Yowie-Tool/Scanner-Dev/Simulator/Pix/first-test.png

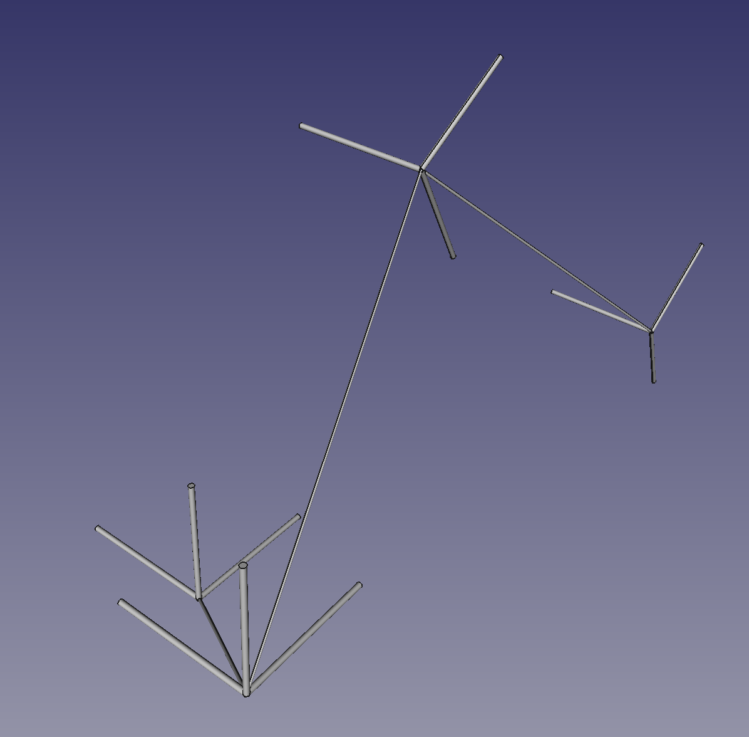
Simulator/Pix/first-test.png
