Yowie-Tool/Scanner-Dev/Simulator/Pix/calibration.png

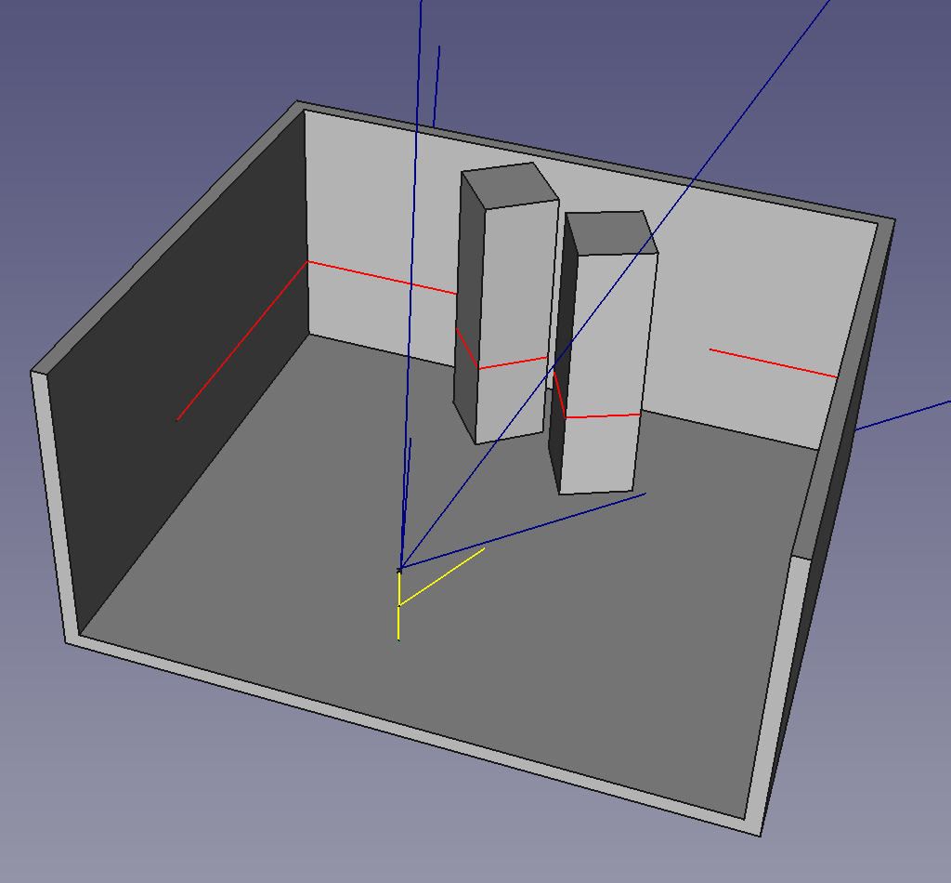
Simulator/Pix/calibration.png
