Yowie-Tool/Scanner-Dev/Simulator/net demand picture v0.2.pptx

+50GW
~50% peak

Interconnector imports

Demand Side Response reduction

Nuclear and Geothermal

Hydrogen

Gas/CCS

Variable renewables only

Batteries and electrically
connected storage use

Net Demand (GW)

CHP

Surplus
(~35% of demand)

Use electricity instead of gas in homes

4000

8640

Deficit

Electrolysis creation
of hydrogen

Hours in year

Store heat

Curtail

Batteries and electrically
connected storage store

Demand Side Response
increase

Interconnector exports

-75GW
