Yowie-Tool/Scanner-Dev/Line Generator/sch1.pdf

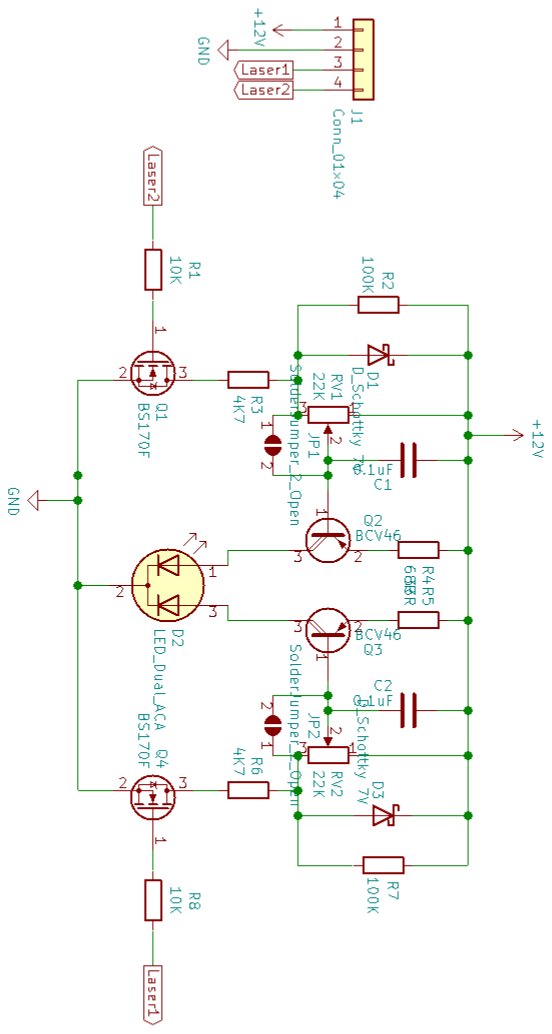
[picture p3: figure]
