Yowie-Tool/Scanner-Dev/Simulator/scanner-error-and-A4-paper-edge-error.ods

Sheet: Sheet1
A4 error | World error
2.96E-11 | 2.07E-11
0.356582834584444 | 0.332942094232495
1.72943543038597 | 1.504357195334
7.50455844831654 | 6.35880334547399
14.3673936406386 | 12.1409991132736
9.78756537702958 | 8.43348527156526
23.6512075498361 | 19.966038607182
46.2608296954759 | 39.261780496724
72.414954830534 | 60.9228884030703
7.04366456682111 | 6.64487412981304
15.2790453416857 | 12.7606081671749
28.3280096288787 | 23.4208571193749
8.31595921452953 | 6.75978969334771
6.75575197121302 | 5.62966116475005
108.781945717244 | 91.3980670708236
51.9931358986265 | 43.6328794534397
37.9781064290804 | 31.4948705997643
25.0638544390871 | 21.7473431589903
10.0748853756272 | 8.37942996782673
36.1126770885016 | 30.5700357944797
89.5823621274084 | 75.5083324300285
94.2375481575226 | 79.4631719529099
71.0746682839919 | 60.000725936289
36.0093804501391 | 29.7812720598132
134.895413170981 | 113.282342240537
57.2119686107465 | 48.8719196907314
99.3585794720821 | 84.4461999838592
142.955585669531 | 120.36169641654
184.773965671629 | 156.56932523244
42.9611357701024 | 36.1425294298019
60.8626346949404 | 52.6046704288228
28.4141960568925 | 24.3986715544768
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
