Yowie-Tool/Scanner-Dev/Line Generator/Line-generator-V2/prototype-stripboard.jpg

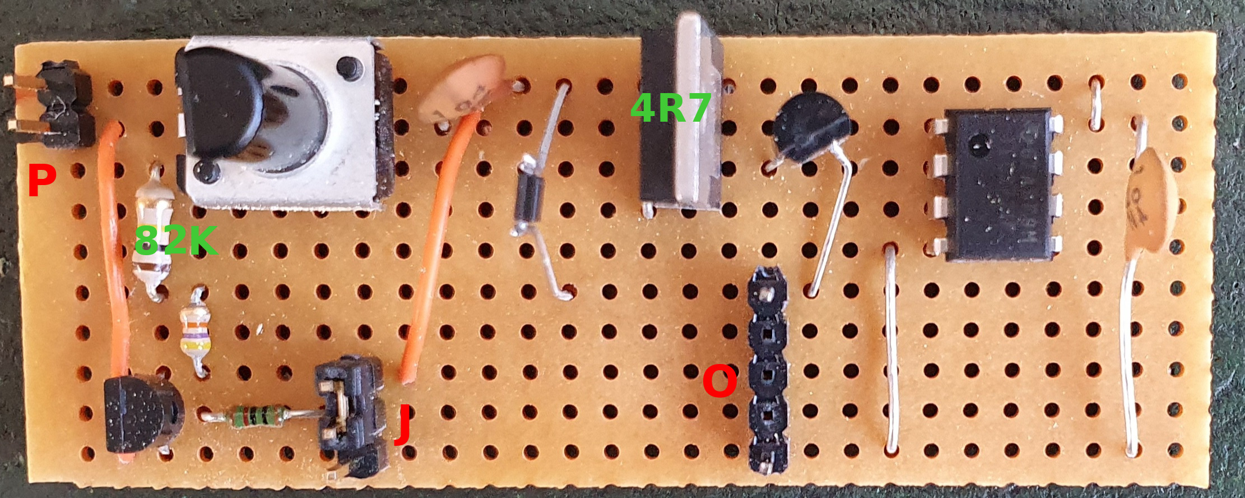
Line Generator/Line-generator-V2/prototype-stripboard.jpg
