Yowie-Tool/Scanner-Dev/Simulator/Pix/correct-output.png

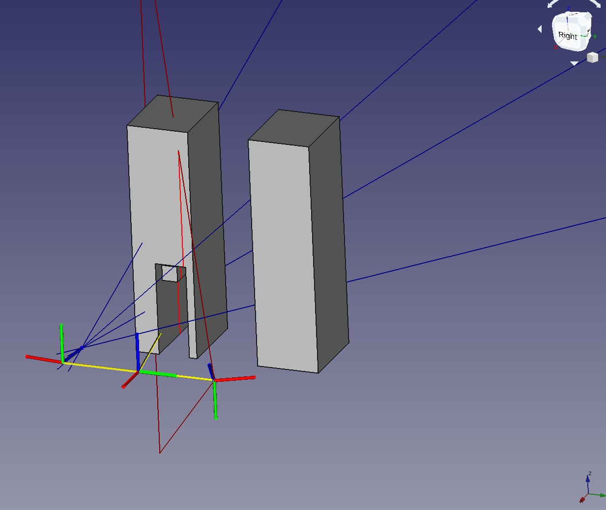
Simulator/Pix/correct-output.png
