Yowie-Tool/Scanner-Dev/Simulator/Pix/first-full-simulation.png

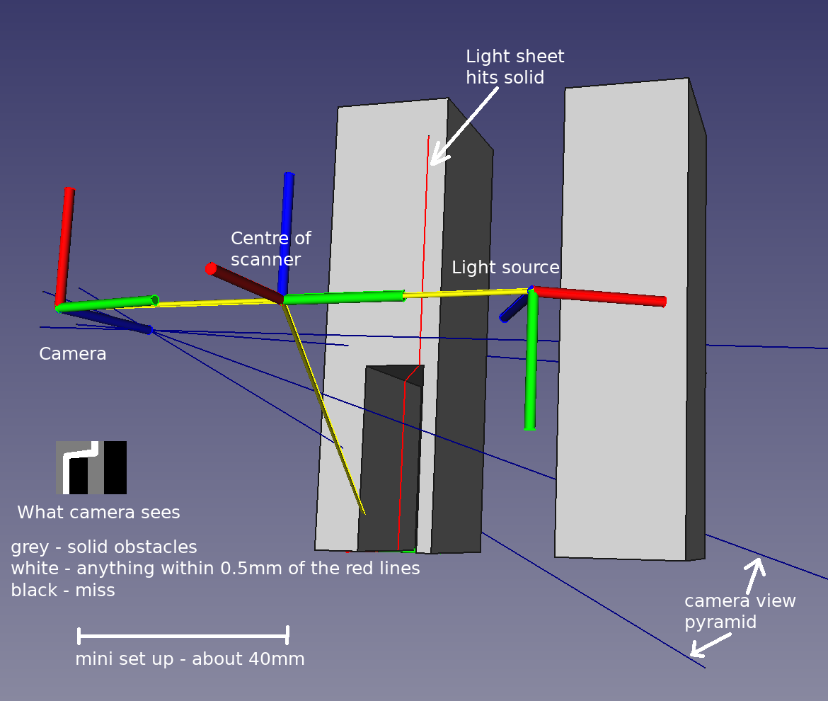
Simulator/Pix/first-full-simulation.png
