Yowie-Tool/Scanner-Dev/Simulator/Pix/light-sheet.png

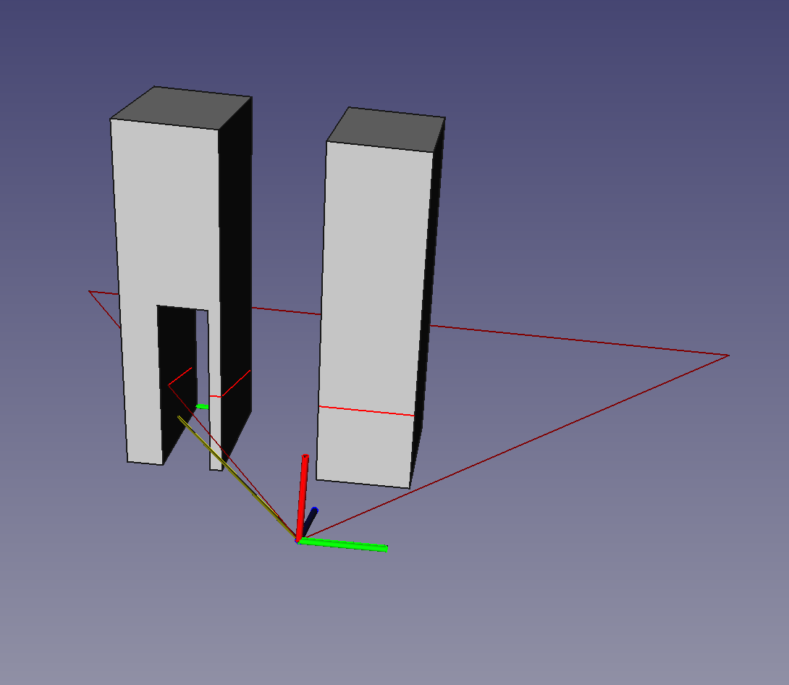
Simulator/Pix/light-sheet.png
