Yowie-Tool/Scanner-Dev/Simulator/Pix/light-slice.png

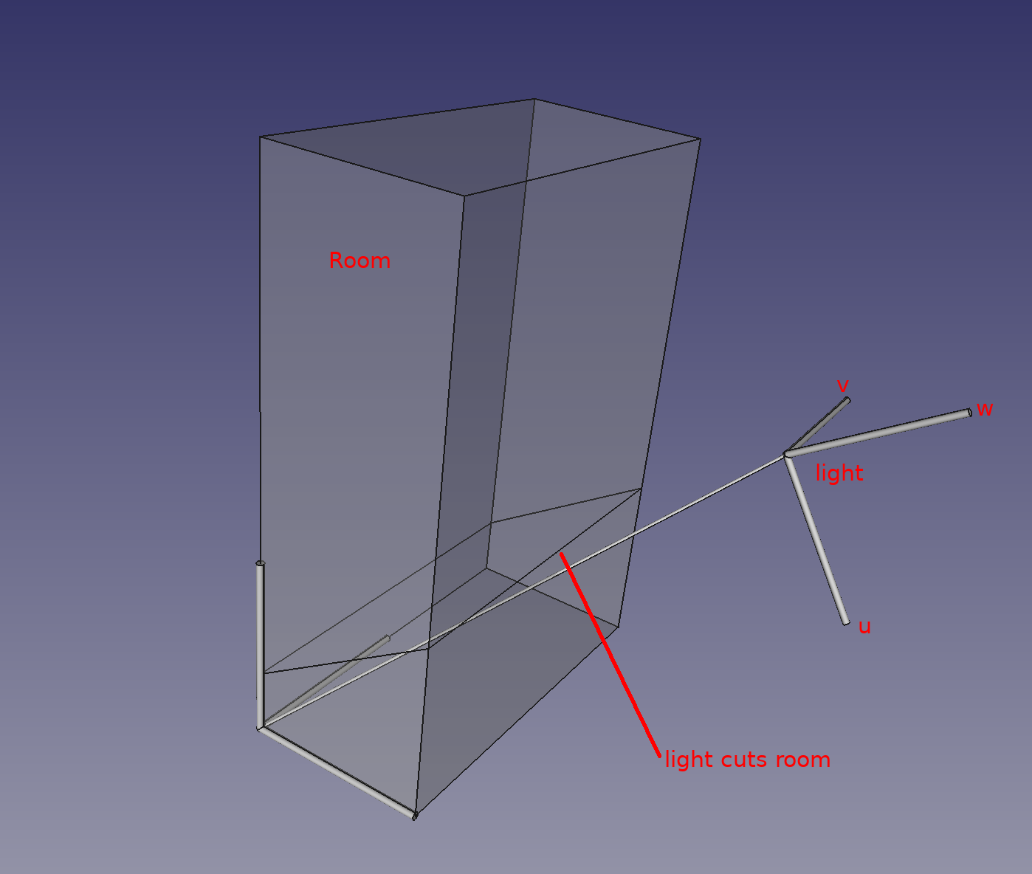
Simulator/Pix/light-slice.png
