Yowie-Tool/Scanner-Dev/Simulator/Pix/vispol.png

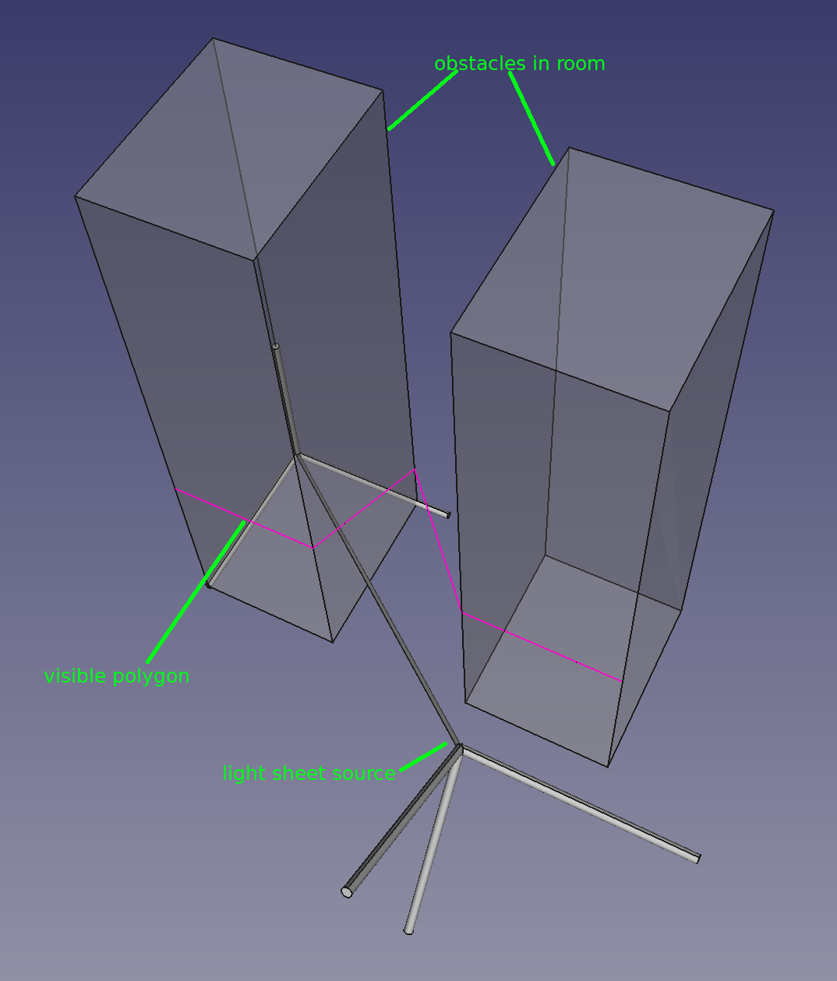
Simulator/Pix/vispol.png
