Yowie-Tool/Scanner-Dev/Simulator/scan.png

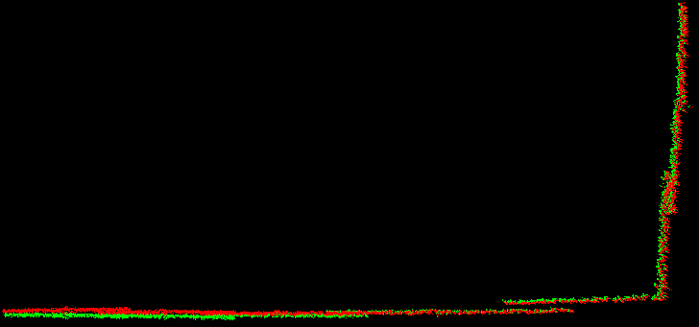
Simulator/scan.png
