Yowie-Tool/Scanner-Dev/Simulator/scanner-comparison1310.png

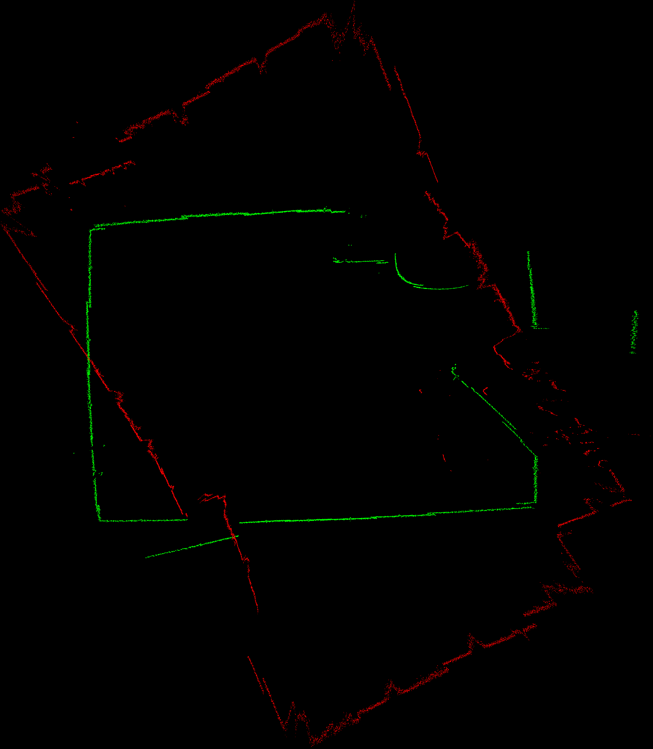
Simulator/scanner-comparison1310.png
