Yowie-Tool/Scanner-Dev/Simulator/scanner-comparison1310a.png

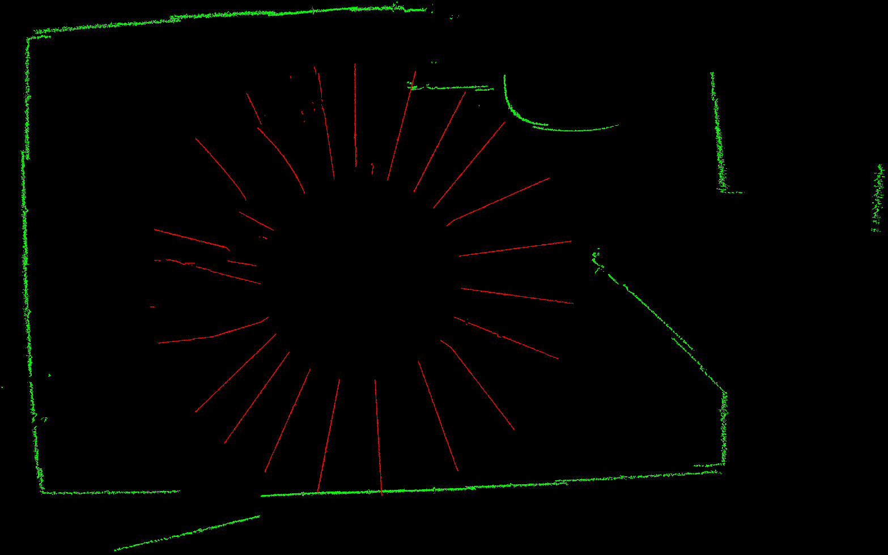
Simulator/scanner-comparison1310a.png
