Yowie-Tool/Scanner-Dev/Simulator/scanner-comparison.png

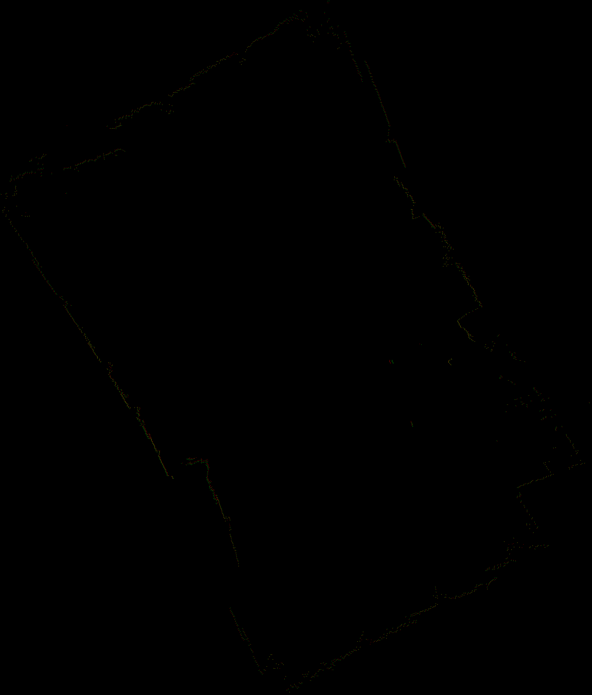
Simulator/scanner-comparison.png
