Yowie-Tool/Scanner-Dev/Simulator/triscan.png

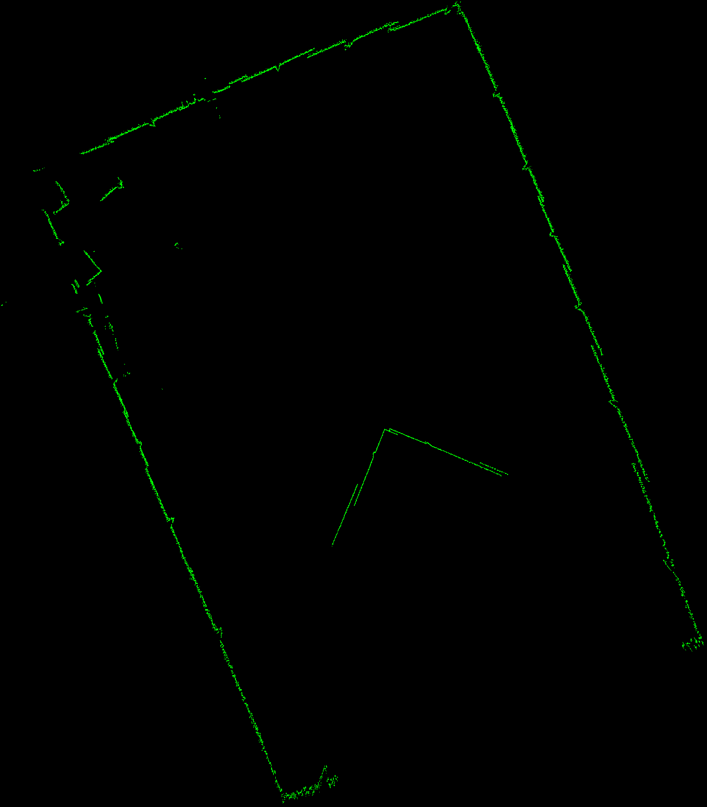
Simulator/triscan.png
