Yowie-Tool/Scanner-Dev/lens-holders.3mf

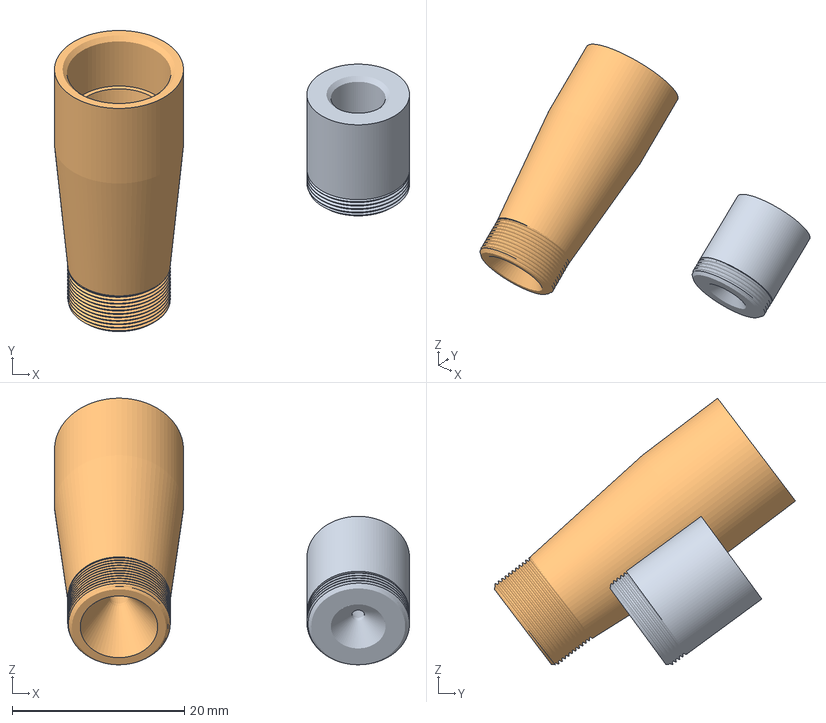
[picture p15: CAD file, 2020-10-10]
lens-holders.3mf
41.3 x 35.0 x 31.0 mm
SS2DP078 7.5mm Focal length lens holder - SLA .stl
SS2DP079 25mm Focal length lens holder - SLA v2.stl
