Yowie-Tool/Scanner-Dev/Line Generator/line-gen-mnt-no-disc.FCStd

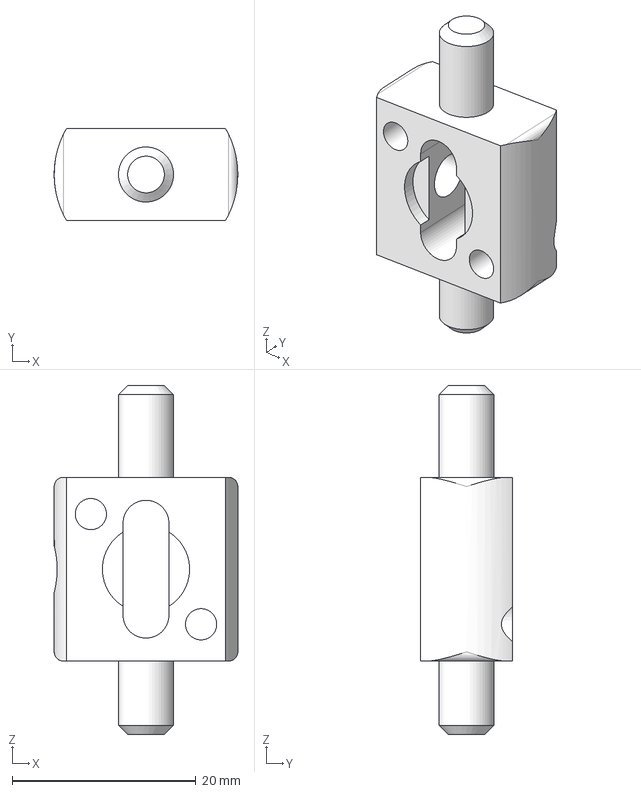
[picture p16: CAD file, 2020-10-10]
Line Generator/line-gen-mnt-no-disc.FCStd
20.0 x 10.0 x 38.0 mm
