Yowie-Tool/Scanner-Dev/Line Generator/Line-generator-V2/3386w-1-103lf.stp

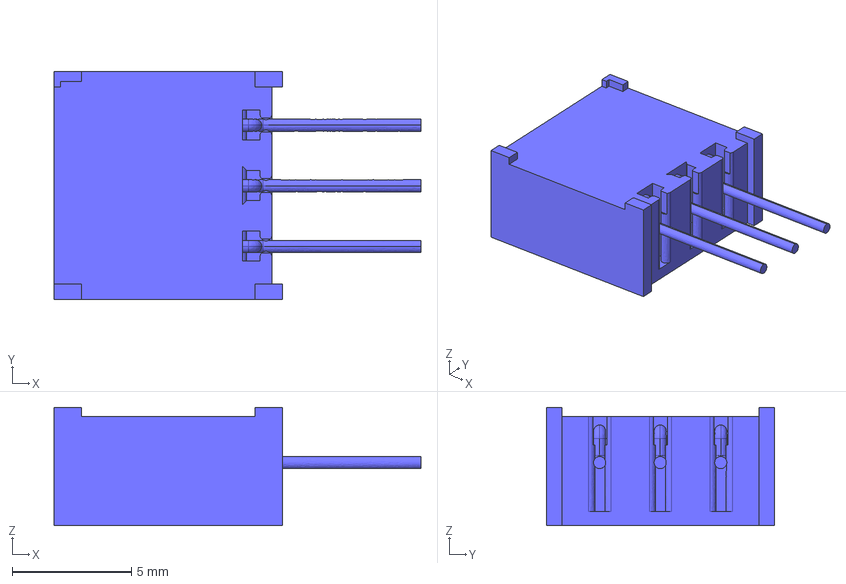
[picture p17: CAD file, 2021-01-26]
Line Generator/Line-generator-V2/3386w-1-103lf.stp
15.4 x 9.58 x 4.95 mm
