Yowie-Tool/Scanner-Dev/New Top Board/FSA642UMX-pcb-part-libraries/FSA642UMX.stp

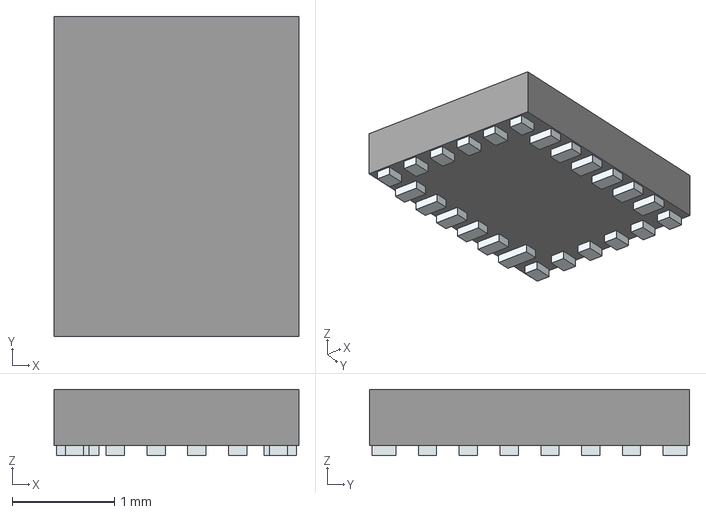
[picture p18: CAD file, 2020-06-26]
New Top Board/FSA642UMX-pcb-part-libraries/FSA642UMX.stp
2.40 x 3.14 x 0.65 mm
Pins
