Yowie-Tool/Scanner-Dev/STL/james-11-10-20.3mf

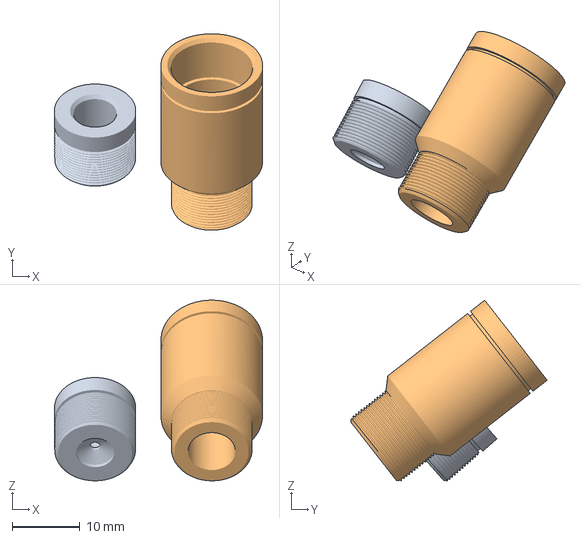
[picture p19: CAD file, 2020-11-02]
STL/james-11-10-20.3mf
30.7 x 29.0 x 26.7 mm
SS2DP076 7.5mm Focal length lens holder v2.stl
SS2DP077 25mm Focal length lens holder v4.stl
