Yowie-Tool/Scanner-Dev/Line Generator/SS2DP029 Line Generator Mount.stp

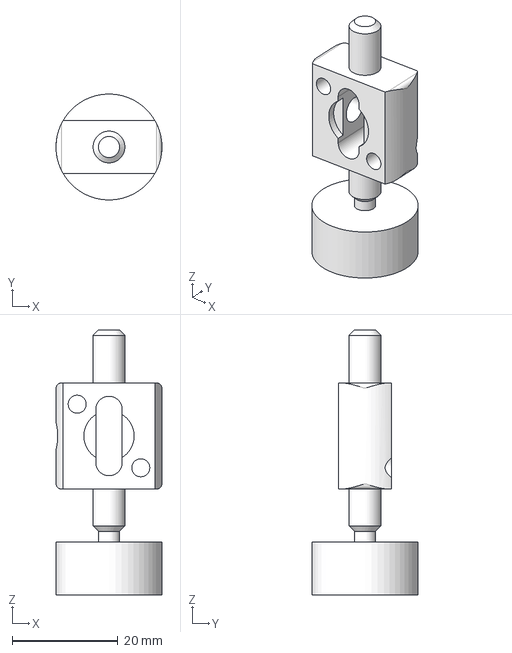
[picture p20: CAD file, 2020-10-10]
Line Generator/SS2DP029 Line Generator Mount.stp
20.0 x 20.0 x 50.0 mm
