Yowie-Tool/Scanner-Dev/SS2DP078 7.5mm Focal length lens holder - SLA .stl

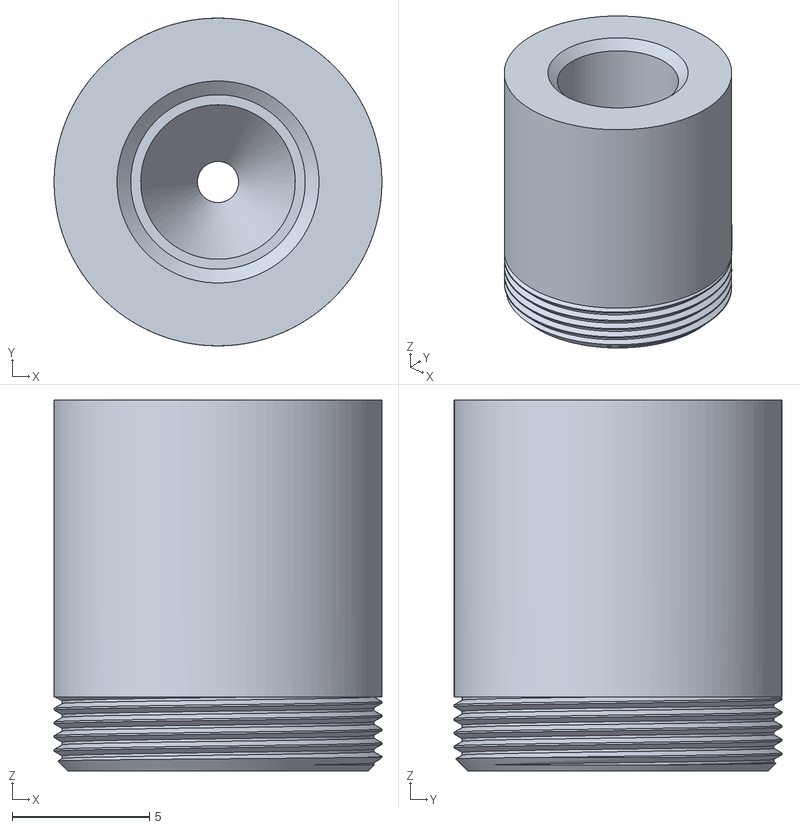
[picture p21: CAD file, 2020-09-29]
SS2DP078 7.5mm Focal length lens holder - SLA .stl
11.9 x 11.9 x 13.5
