Yowie-Tool/Scanner-Dev/STL/SS2DP081 Additional Back Panel Mount.stl

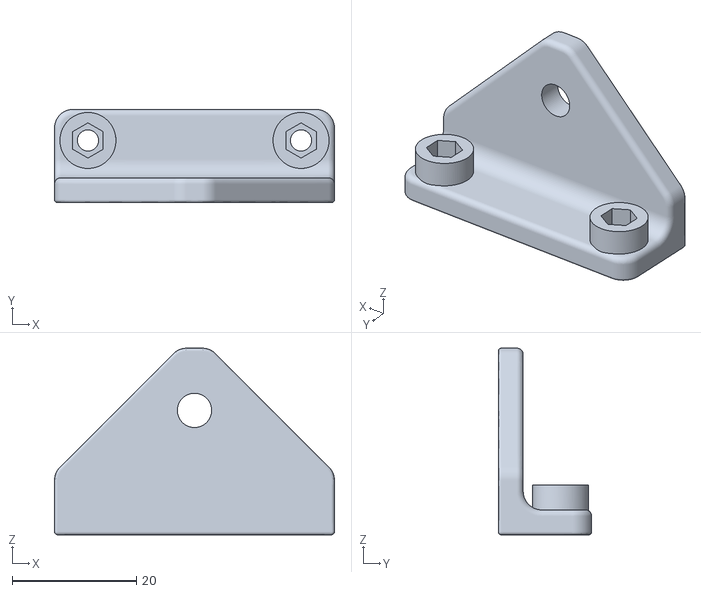
[picture p22: CAD file, 2020-10-10]
STL/SS2DP081 Additional Back Panel Mount.stl
45.0 x 15.0 x 30.0
