Yowie-Tool/Scanner-Dev/SS2DP079 25mm Focal length lens holder - SLA v2.stl

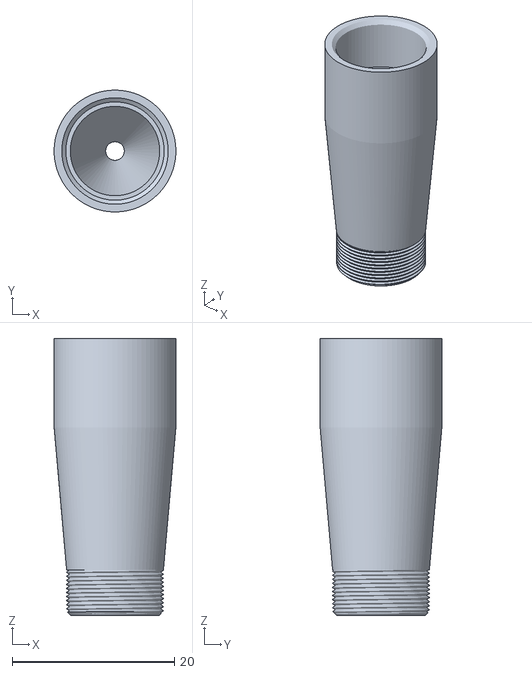
[picture p23: CAD file, 2020-09-29]
SS2DP079 25mm Focal length lens holder - SLA v2.stl
15.0 x 15.0 x 34.1
