Yowie-Tool/Scanner-Dev/STL/SS2DP039 Base Cable Protector.stl

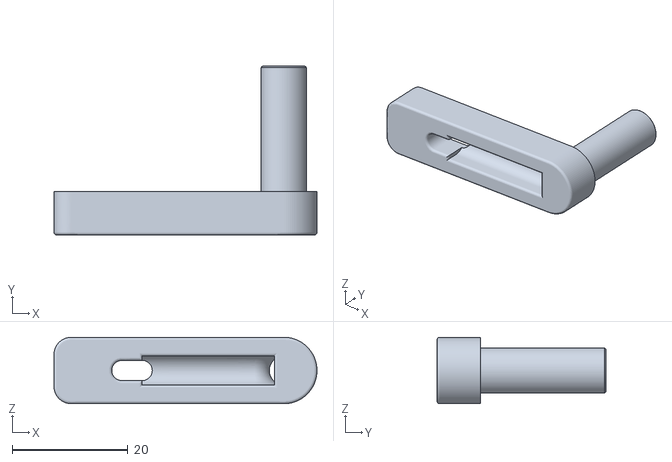
[picture p24: CAD file, 2020-10-10]
STL/SS2DP039 Base Cable Protector.stl
45.5 x 29.3 x 11.5
