Yowie-Tool/Scanner-Dev/Line Generator/Line Generator.step

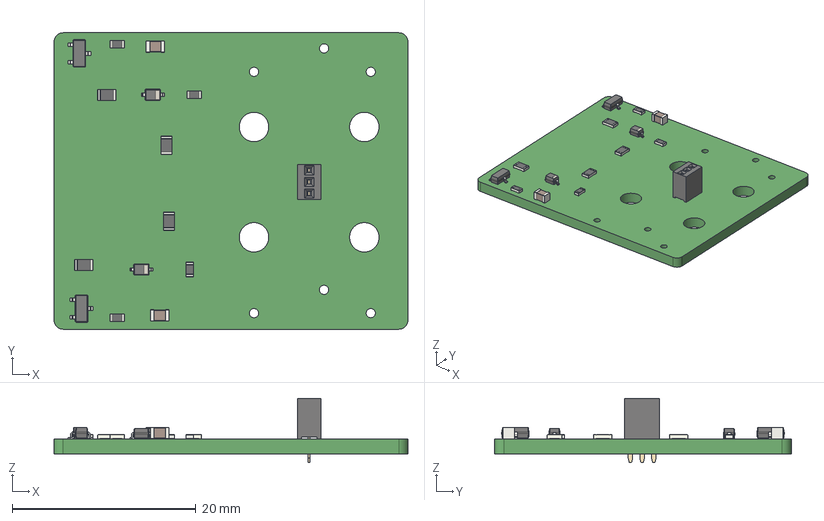
[picture p25: CAD file, 2020-03-01]
Line Generator/Line Generator.step
38.5 x 32.2 x 7.00 mm
