Yowie-Tool/Scanner-Dev/STL/SS2DP003 Base Support V2.stl

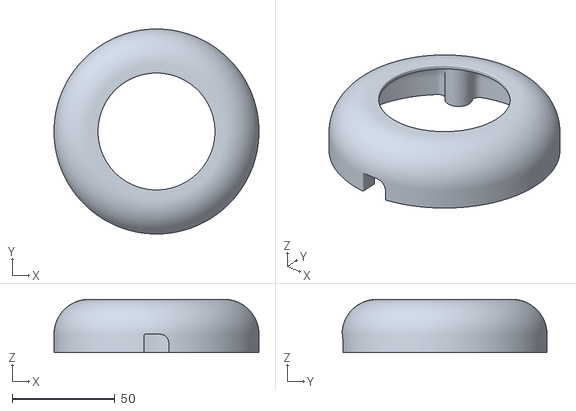
[picture p26: CAD file, 2020-10-10]
STL/SS2DP003 Base Support V2.stl
100.0 x 100.0 x 26.0
