Yowie-Tool/Scanner-Dev/STL/james-3-10-20.3mf

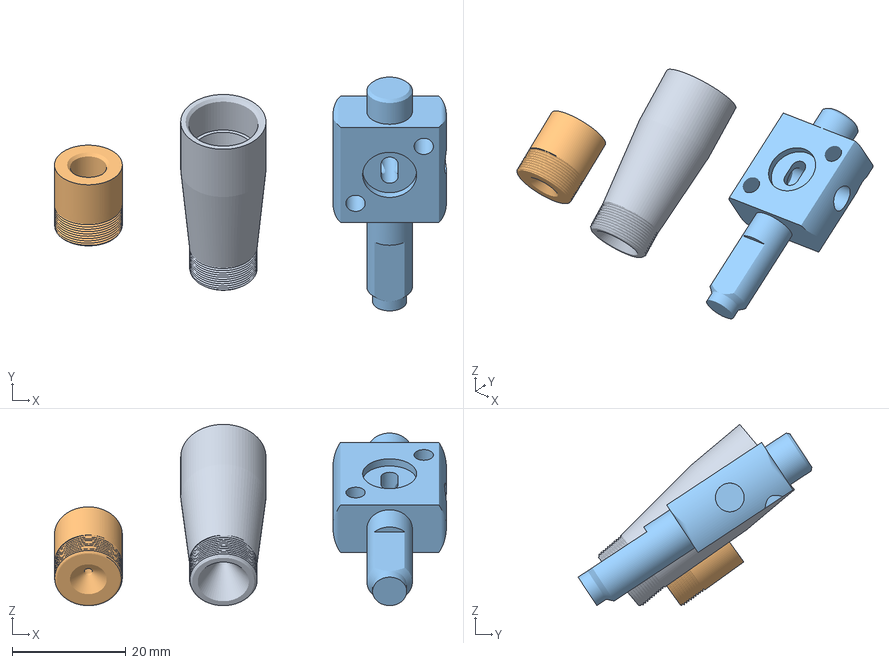
[picture p27: CAD file, 2020-10-10]
STL/james-3-10-20.3mf
69.0 x 41.1 x 31.9 mm
SS2DP079 25mm Focal length lens holder - SLA v4.stl
SS2DP078 7.5mm Focal length lens holder - SLA v4.stl
SS2DP029 Line Generator Mount.stl
