Yowie-Tool/Scanner-Dev/STL/james-4-10-20.3mf

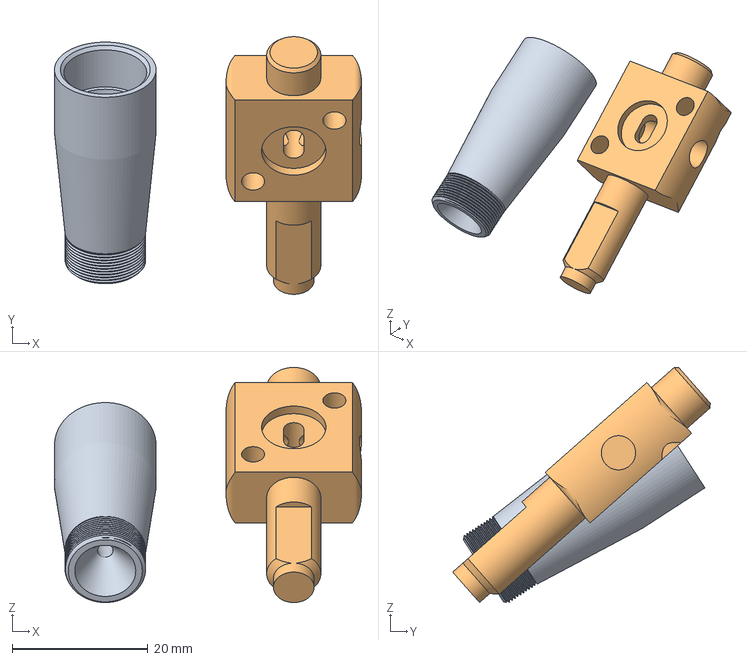
[picture p28: CAD file, 2020-10-10]
STL/james-4-10-20.3mf
45.3 x 38.0 x 34.7 mm
SS2DP079 25mm Focal length lens holder - SLA v4.stl
SS2DP029 Line Generator Mount.stl
