Yowie-Tool/Scanner-Dev/STL/SS2DP077 25mm Focal length lens holder v4.stl

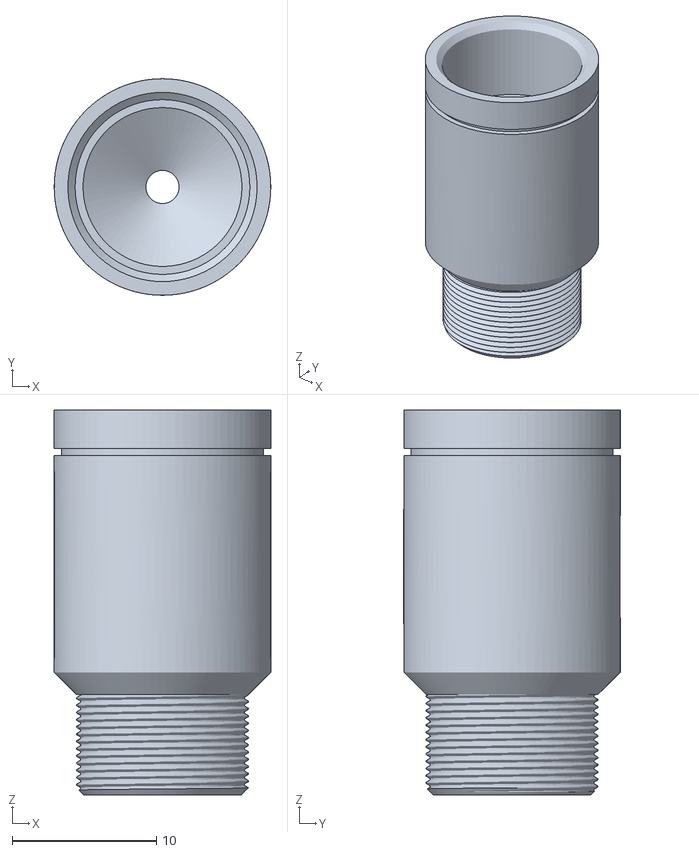
[picture p29: CAD file, 2020-10-10]
STL/SS2DP077 25mm Focal length lens holder v4.stl
15.0 x 15.0 x 26.7
