Yowie-Tool/Scanner-Dev/STL/SS2DP076 7.5mm Focal length lens holder v2.stl

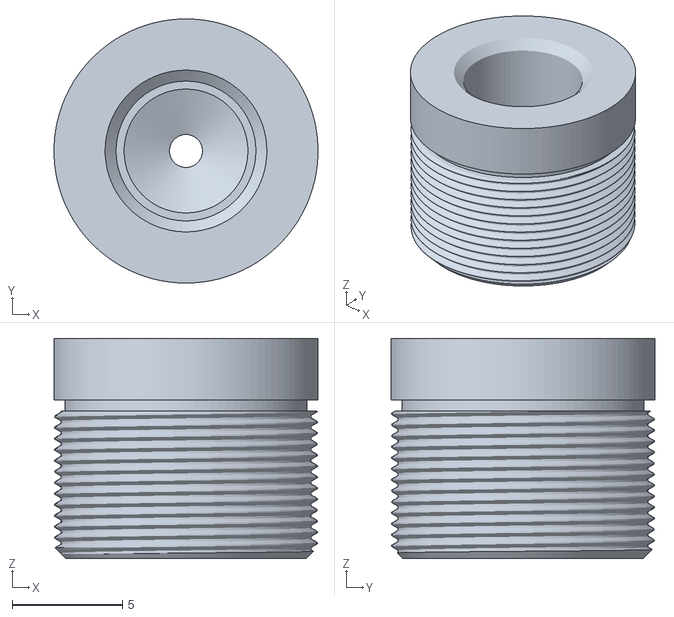
[picture p30: CAD file, 2020-10-10]
STL/SS2DP076 7.5mm Focal length lens holder v2.stl
12.0 x 12.0 x 10.0
