Yowie-Tool/Scanner-Dev/STL/SS2DP045 Screen Support 1.stl

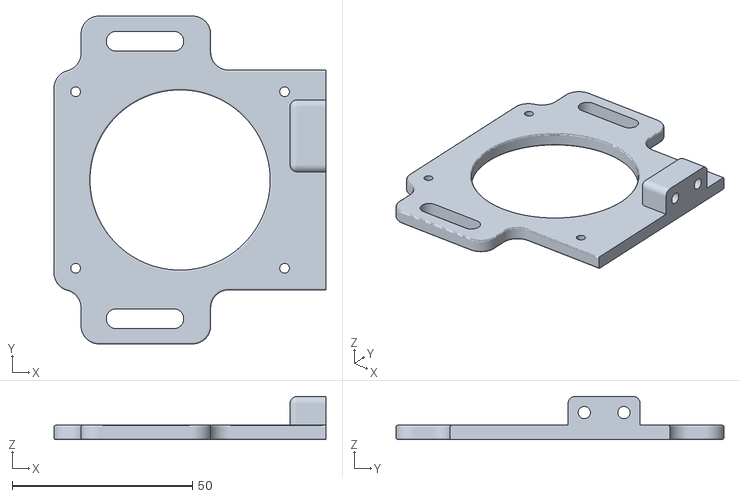
[picture p31: CAD file, 2020-10-10]
STL/SS2DP045 Screen Support 1.stl
75.5 x 91.0 x 12.0
