Yowie-Tool/Scanner-Dev/STL/SS2DP029 Line Generator Mount.stl

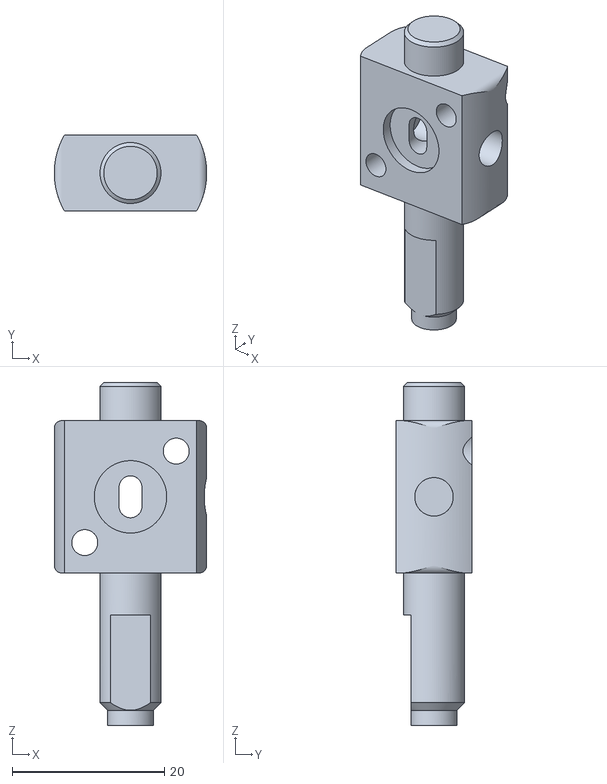
[picture p32: CAD file, 2020-10-03]
STL/SS2DP029 Line Generator Mount.stl
20.0 x 10.0 x 45.0
