Yowie-Tool/Scanner-Dev/(list of files, cad)

Other CAD files:
Line Generator/line-gen-mnt.stl
Line Generator/Legacy/line-gen-mnt.stl
New Top Board/FSA642UMX-pcb-part-libraries/FSA642UMX.stl
New Top Board/FSA642UMX-pcb-part-libraries/LIB_GET/FSA642UMX/3D/FSA642UMX.stl
New Top Board/FSA642UMX-pcb-part-libraries/LIB_GET/FSA642UMX/Allegro/fsa642umx.psm
New Top Board/FSA642UMX-pcb-part-libraries/LIB_GET/FSA642UMX/DEHDL/fsa642umx/chips/chips.prt
Small Camera Adapter/10137062-00021LF/s10137062/10137062c.stp
digikey-kicad-library-master/1-1734248-5.stl
digikey-kicad-library-master/1-1734248-5.stp
digikey-kicad-library-master/647676-2/647676-2.igs
digikey-kicad-library-master/647676-2/647676-2.stl
digikey-kicad-library-master/647676-2/647676-2.x_b
digikey-kicad-library-master/68611514122/68611514122_Download_STP_68611514122_rev1.stp
digikey-kicad-library-master/87832-1211-ecad-part-wizard-3-en/87832-1211.stl
digikey-kicad-library-master/87832-1211-ecad-part-wizard-3-en/87832-1211.stp
digikey-kicad-library-master/87832-1211-ecad-part-wizard-3-en/LIB_GET/87832-1211/3D/87832-1211.stl
digikey-kicad-library-master/87832-1211-ecad-part-wizard-3-en/LIB_GET/87832-1211/Allegro/878321211.psm
digikey-kicad-library-master/87832-1211-ecad-part-wizard-3-en/LIB_GET/87832-1211/DEHDL/87832_1211/chips/chips.prt
digikey-kicad-library-master/87832-1211-ecad-part-wizard-3-en/RJE392881400.stl
digikey-kicad-library-master/87832-1211-ecad-part-wizard-3-en/RJE392881400.stp
digikey-kicad-library-master/Amphenol RJ45 Double/RJE392881400-pcb-part-libraries/LIB_GET/RJE392881400/3D/RJE392881400.stl
digikey-kicad-library-master/Amphenol RJ45 Double/RJE392881400-pcb-part-libraries/LIB_GET/RJE392881400/3D/RJE392881400.stp
digikey-kicad-library-master/Amphenol RJ45 Double/RJE392881400-pcb-part-libraries/LIB_GET/RJE392881400/Allegro/rje392881400.psm
digikey-kicad-library-master/Amphenol RJ45 Double/RJE392881400-pcb-part-libraries/LIB_GET/RJE392881400/DEHDL/rje392881400/chips/chips.prt
digikey-kicad-library-master/Amphenol RJ45 Double/RJE392881400-pcb-part-libraries/RJE392881400 - old.stp
digikey-kicad-library-master/Amphenol RJ45 Double/RJE392881400-pcb-part-libraries/RJE392881400.stl
digikey-kicad-library-master/C5750X7R1C476M230KB/CGA9N3X7R2E105K230KE--3DModel-STEP-56544.STEP
digikey-kicad-library-master/JS5208/JS5208.stp
digikey-kicad-library-master/LMR14050SDDAR/LMR14050SDDAR--3DModel-STEP-56544.STEP
digikey-kicad-library-master/LMZ31506.stl
