Yowie-Tool/Scanner-Dev/Camera-characteristics/Camera Lenses.xlsx

Sheet: Sheet1
Camera | Pi | 9MP | 13MP | 14MP
Lens Mount | CS/None | M12 | None | M12
Overlap | 5 | 1.5 | 1.6 | 1
Lens 1 | 8 | 12 | 10 | 12
Lens 2 | 25 | 50 | 35 | 50
Range | 5782 | 6830 | 6200 | 8052 |  |  |  | 450
Range +/- 1mm | 4250 | 4750 | 5000 | 5500 |  |  |  | 345
 |  |  |  |  |  |  |  | 105 | 240
Lenses needed | 8 |  |  |  |  |  |  | 0
 | 10
 | 12
 | 25 | got CS
 | 35
 | 50
M12/S mount | M12*0.5
CS | 1" x 32 TPI UN 2A
400 | 8.137912
325 | 20.171271 | 40.342542
diff | 12.033359
 |  |  |  |  |  | angled | x angle
345 | 8 | 2000 | 2050 | (2203 max) | 68.25 | 21.75 | 25.7
450 | 25 |  | 2050 | 6.4m range | 81.8 | 8.2 | 8.37
300 | 9 |  | 2119
400 | 25 |  | 1894
7.5 Deg | 50mm
26.7 Deg | 12mm
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
