Yowie-Tool/Scanner-Dev/Camera-characteristics/camera-variables.ods

 | Camera 1 | Camera 2
Dn | 0.750 | 2.200
Df | 1.500 | 4.250 |  |  |  | Example 1
f | 0.00800 | 0.02500 |  |  |  | s | N | H | Dn | Df
h | 0.00368 | 0.00368 |  |  |  | 1.000 | 6.000 | 3.486 | 0.778089 | 1.399
c | 0.00000 | 0.00000
M | 0.500 | 1.467
Fd | 2.250 | 6.375
 | s1 | s2 | N1 | N2 | theta1 | theta2 | t1 | t2 | a1 | b1 | c1 | L1+ | L1- | a2 | b2 | c2 | L2+ | L2-
0.000 | 0.500 | 1.467 | -14.139 | -47.122 | 0.445 | 0.144 | 2.096 | 6.875 | 1.000 | -3.66817714033227 | 1.125 | 3.330 | 0.338 | 1.000 | -10.2883635031224 | 9.350 | 9.281 | 1.007
0.050 | 0.588 | 1.712 | -7.803 | -26.792 | 0.446 | 0.145 | 2.090 | 6.858 | 1.000 | -3.6583572897702 | 1.125 | 3.319 | 0.339 | 1.000 | -10.2608211603555 | 9.350 | 9.250 | 1.011
0.100 | 0.675 | 1.958 | -3.129 | -11.625 | 0.447 | 0.145 | 2.086 | 6.845 | 1.000 | -3.65111237050557 | 1.125 | 3.311 | 0.340 | 1.000 | -10.240500886799 | 9.350 | 9.227 | 1.013
0.150 | 0.763 | 2.203 | 0.461 | 0.124 | 0.448 | 0.145 | 2.083 | 6.835 | 1.000 | -3.64554698553748 | 1.125 | 3.305 | 0.340 | 1.000 | -10.2248913070551 | 9.350 | 9.210 | 1.015
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
