Yowie-Tool/Scanner-Dev/Simulator/A4-paper-error-simulation-test.png

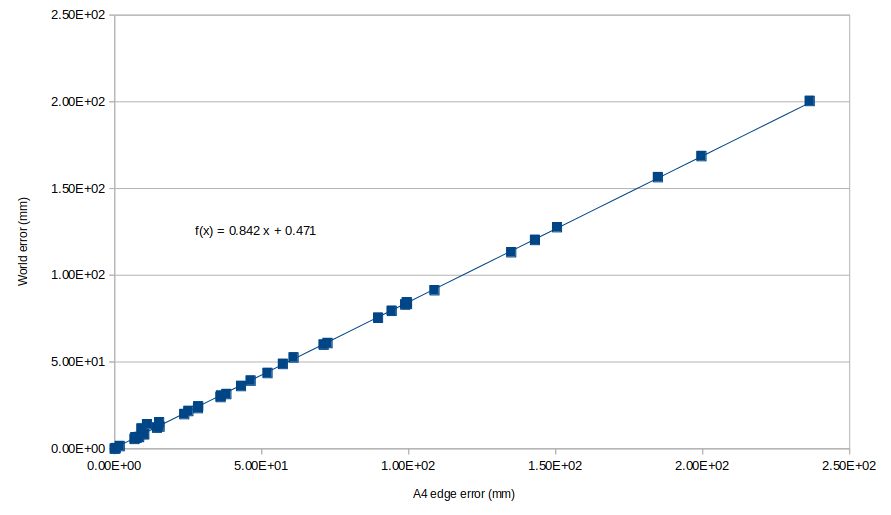
Simulator/A4-paper-error-simulation-test.png
