Yowie-Tool/Scanner-Dev/Simulator/A4-paper-small-error-simulation-test.png

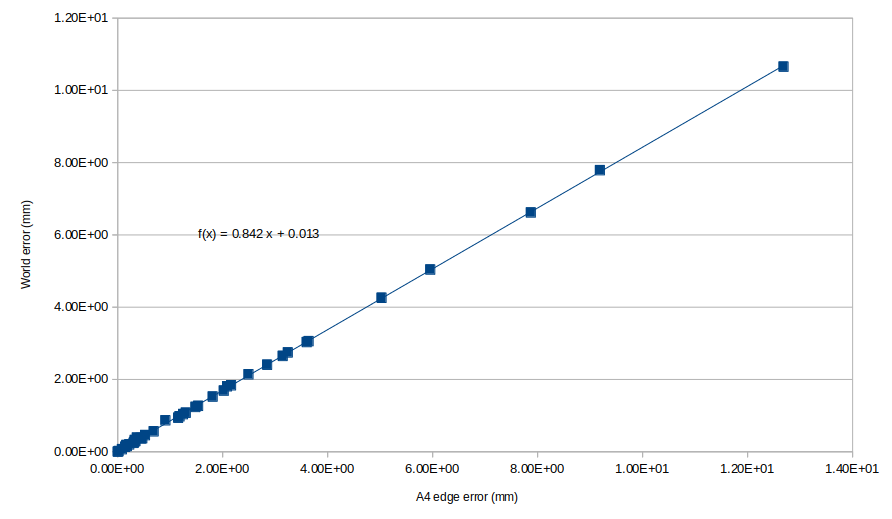
Simulator/A4-paper-small-error-simulation-test.png
