Yowie-Tool/Scanner-Dev/Simulator/RoomReaderScanDebug.txt

../../ScannerV4/Scans/RoomReaderScanDebug.txt
