Yowie-Tool/Scanner-Dev/New Top Board/Top Board.pdf

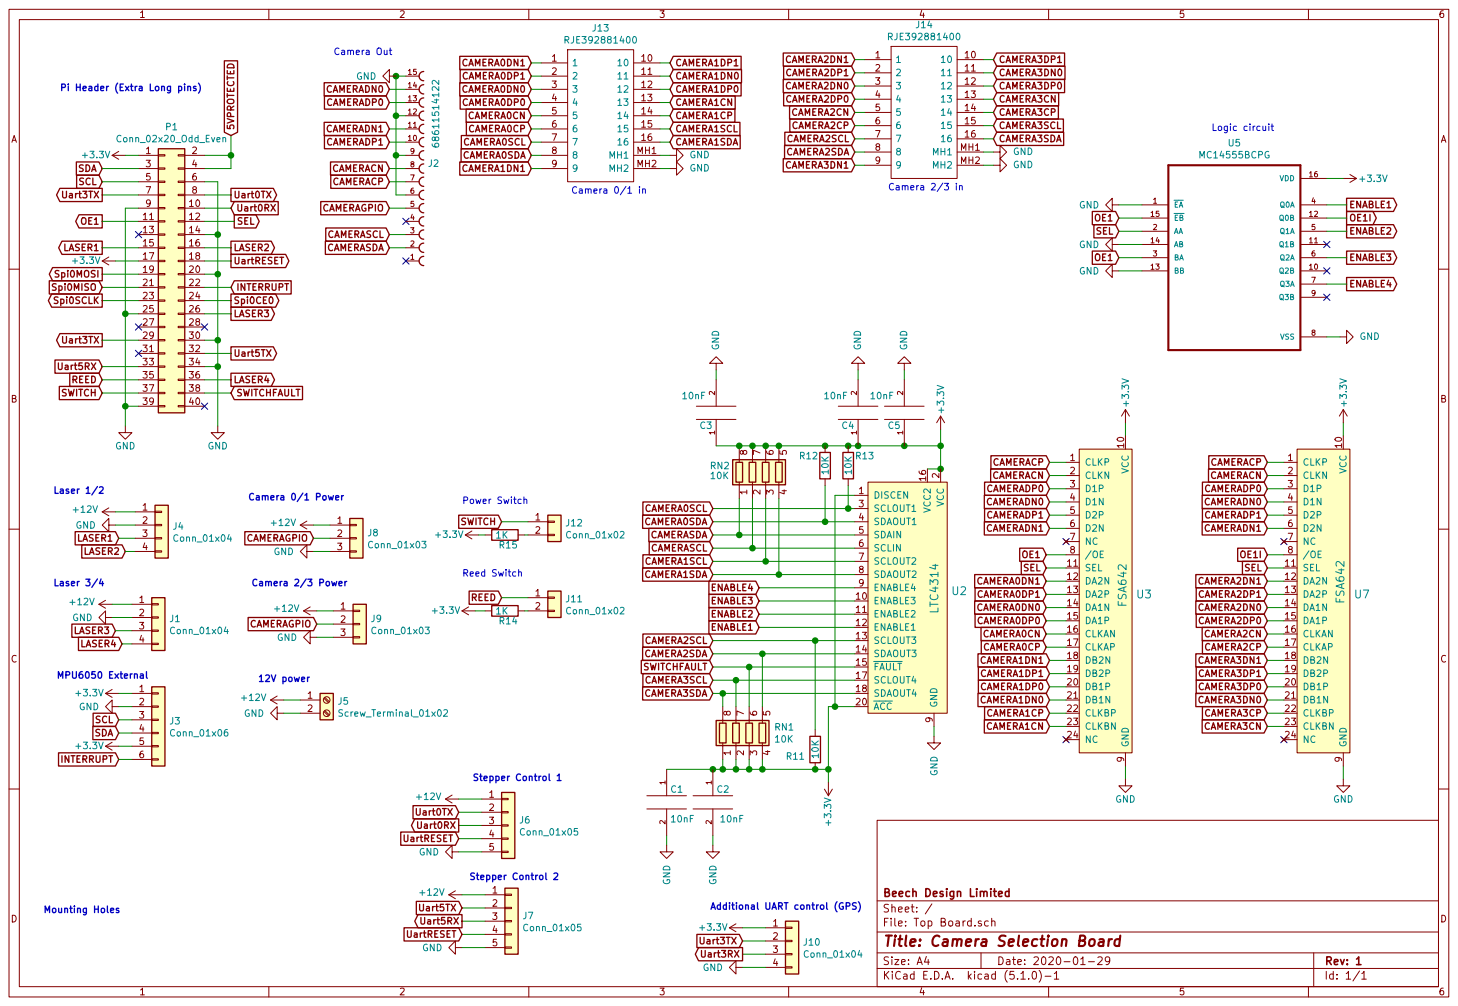
[picture p35: page 1]

9 U7 FSA642 OE1 SEL GND+3.3V CLKP 1 VCC 10 SEL 11 DA2N 12 DA2P 13 DA1N 14 DA1P 15 CLKAN 16 CLKAP 17 DB2N 18 DB2P 19 CLKN 2 DB1P 20 DB1N 21 CLKBP 22 CLKBN 23 NC 24 D1P 3 D1N 4 D2P 5 D2N 6 NC 7

2 ACC 20 SCLOUT1 3 SDAOUT1 4 SDAIN 5 SCLIN 6 SCLOUT2 7 SDAOUT2 8 ENABLE4 9 GND

Id: 1/1 Title: Camera Selection Board
