Yowie-Tool/Scanner-Dev/Stepper motor controller/Stepper motor controller V2.pdf

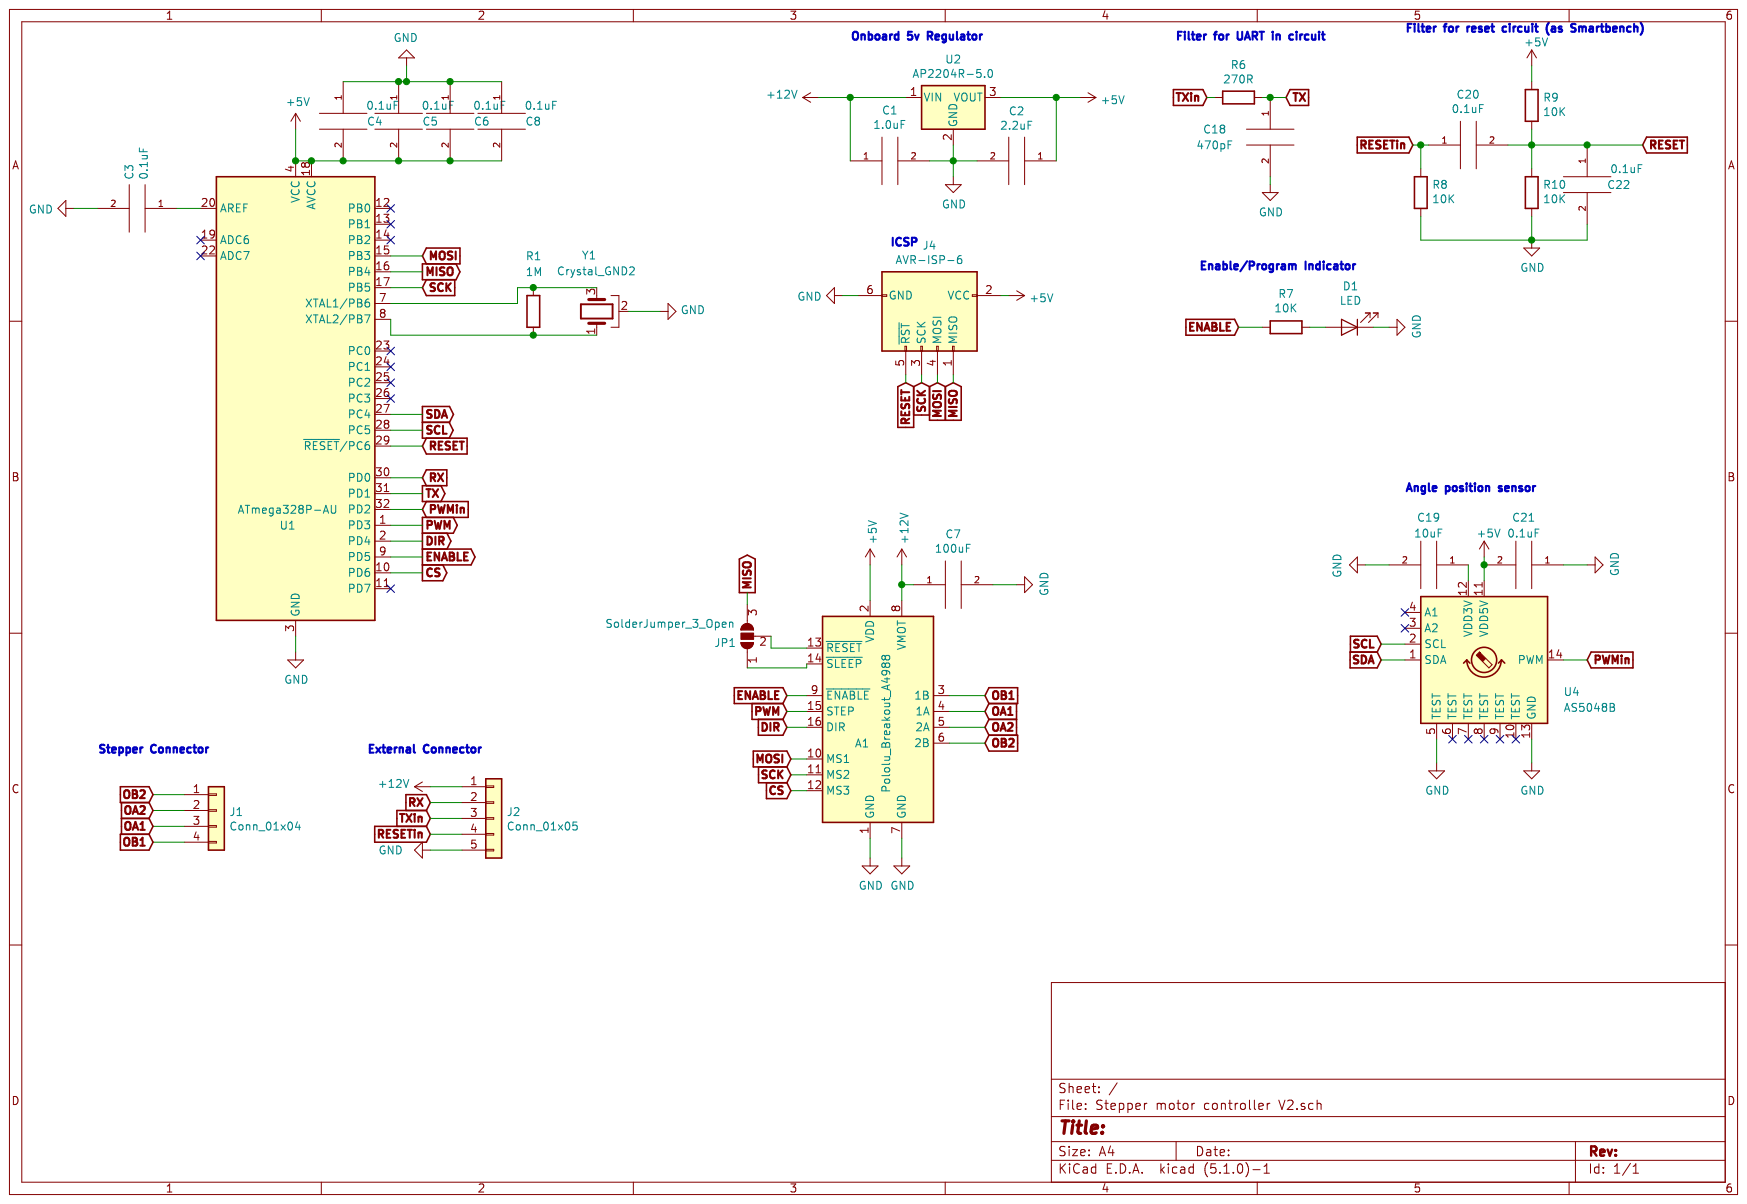
[picture p36: page 1]
