Yowie-Tool/Scanner-Dev/Universal Interface Board/Universal Interface Board - Copy.pdf

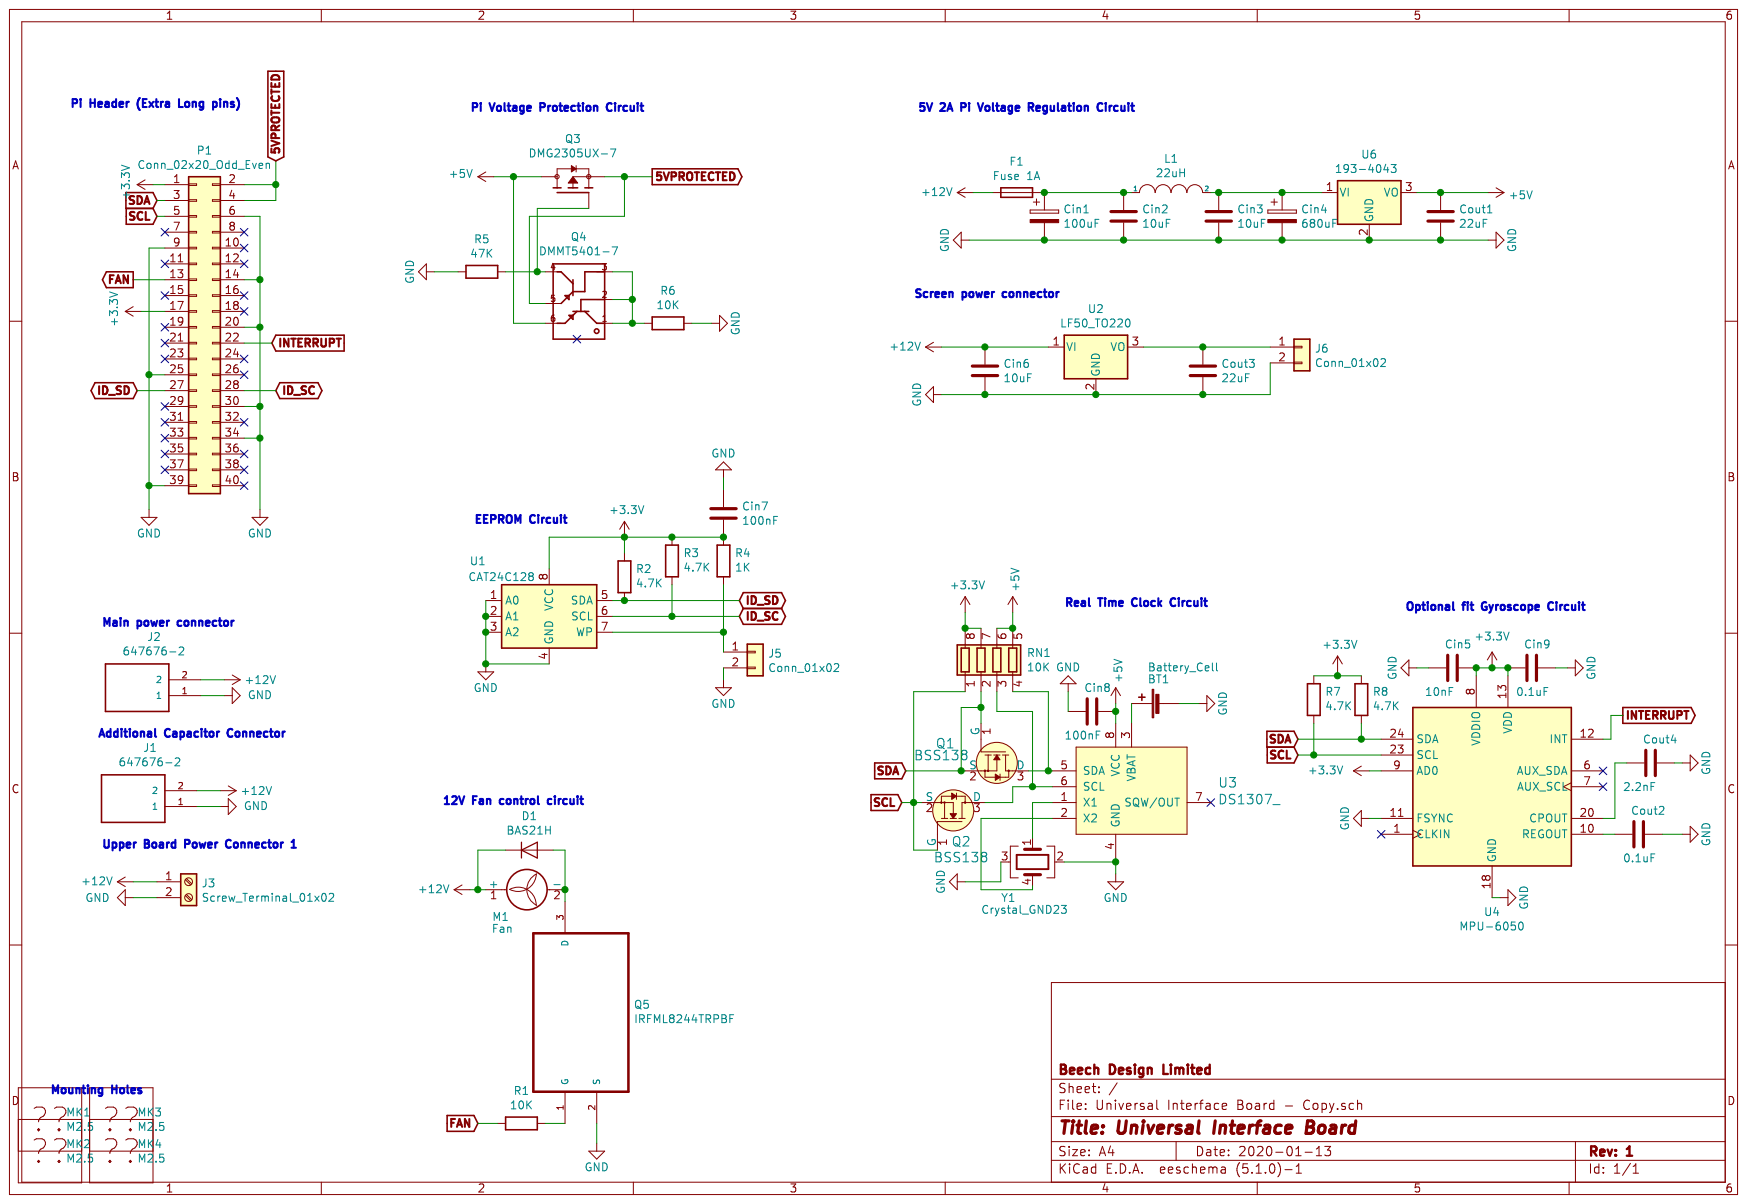
[picture p37: page 1]
