Yowie-Tool/Scanner-Dev/Line Generator/Line Generator.pdf

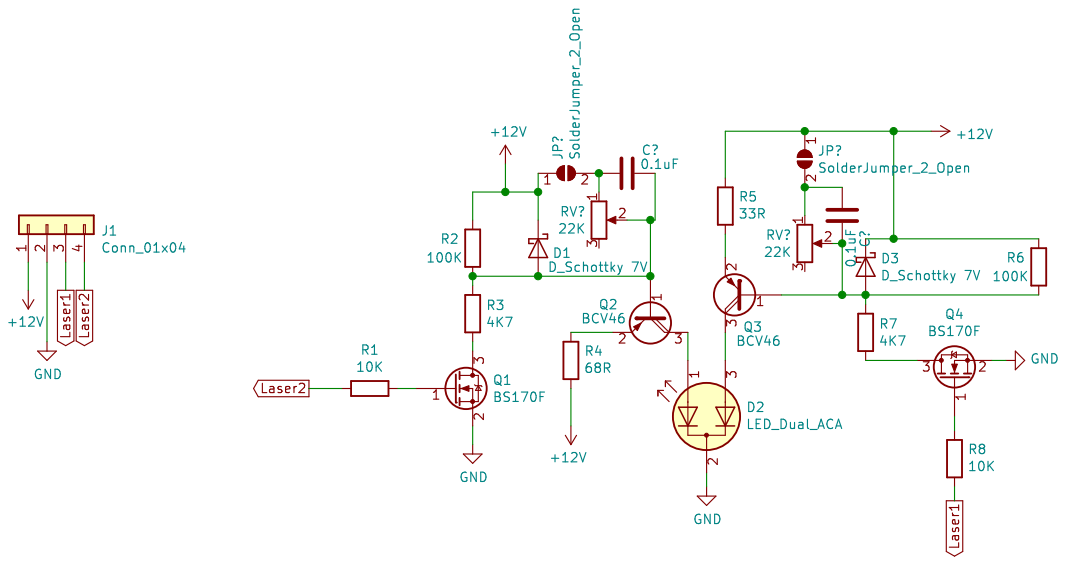
[picture p38: page 1]
