Yowie-Tool/Scanner-Dev/Line Generator/Line-generator-V2/Line-Generator-V2.pdf

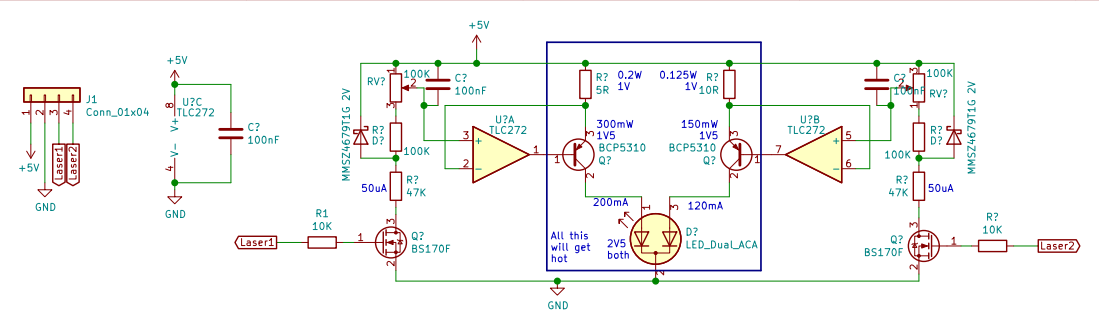
[picture p39: page 1]

All this will get hot

Id: 1/1 Title: File: Line-Generator-V2.sch Sheet: /
