Yowie-Tool/Scanner-Dev/(list of files, drawings)

Other design files:
Camera Adapter/Camera Adapter.dsn
Line Generator/Legacy/Line Generator.dsn
Line Generator/Line Generator.dsn
Line Generator/Line-generator-V2/Line-Generator-V2.dsn
New Top Board/Top Board.dsn
Small Camera Adapter/Small Camera Adapter.dsn
Stepper motor controller/Stepper motor controller V2.dsn
Universal Interface Board/Universal Interface Board - Copy.dsn
