Yowie-Tool/Scanner-Dev/Small Camera Adapter/Small Camera Adapter.kicad_pcb

## KiCad design Small Camera Adapter/Small Camera Adapter.kicad_pcb (2021-03-05)

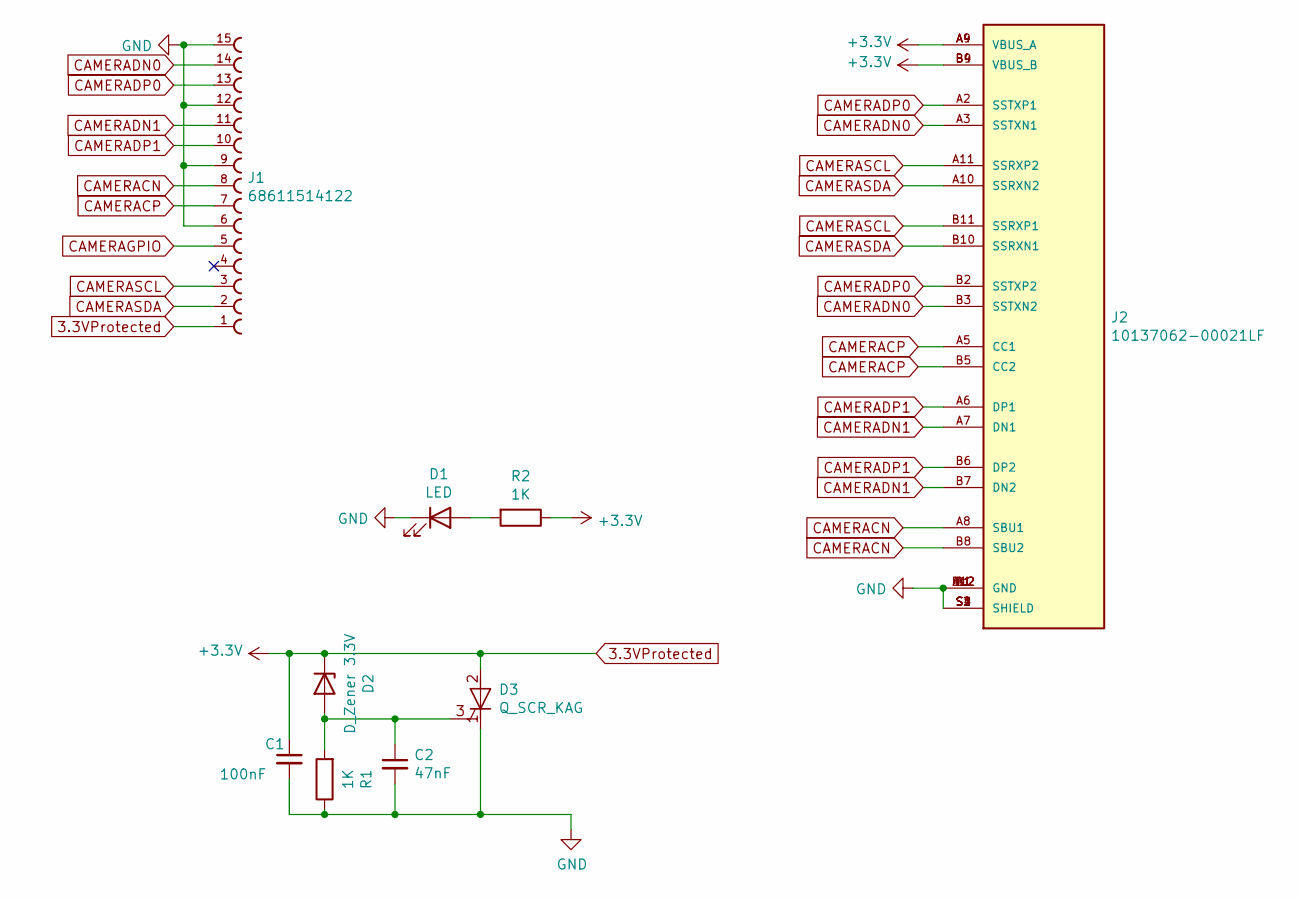
[picture p40: schematic Small Camera Adapter.sch]

Parts:
C1: 100nF; C_0805_2012Metric_Pad1.18x1.45mm_HandSolder
C2: 47nF; C_0805_2012Metric_Pad1.18x1.45mm_HandSolder
D1: LED; LED_0805_2012Metric_Pad1.15x1.40mm_HandSolder
D2: D_Zener 3.3V; D_SOD-123F
D3: Q_SCR_KAG; DPAK
J1: 68611514122
J2: 10137062-00021LF; CONN_10137062-00021LF; PARTREV B
R1: 1K; R_0805_2012Metric_Pad1.20x1.40mm_HandSolder
R2: 1K; R_0805_2012Metric_Pad1.15x1.40mm_HandSolder

Connections:
3.3VProtected: C1.1, D2.1 (K), D3.2 (A), J1.1 (15), J2.A4 (VBUS_A), J2.A9 (VBUS_A), J2.B4 (VBUS_B), J2.B9 (VBUS_B), R2.1
CAMERACN: J1.8, J2.A8 (SBU1), J2.B8 (SBU2)
CAMERACP: J1.7 (9), J2.A5 (CC1), J2.B5 (CC2)
CAMERADN0: J1.14 (2), J2.A3 (SSTXN1), J2.B3 (SSTXN2)
CAMERADN1: J1.11 (5), J2.A7 (DN1), J2.B7 (DN2)
CAMERADP0: J1.13 (3), J2.A2 (SSTXP1), J2.B2 (SSTXP2)
CAMERADP1: J1.10 (6), J2.A6 (DP1), J2.B6 (DP2)
CAMERAGPIO: J1.5 (11)
CAMERASCL: J1.3 (13), J2.A11 (SSRXP2), J2.B11 (SSRXP1)
CAMERASDA: J1.2 (14), J2.A10 (SSRXN2), J2.B10 (SSRXN1)
GND: C1.2, C2.2, D1.1 (K), D3.1 (K), J1.6 (10), J1.9 (7), J1.12 (4), J1.15 (1), J2.A1 (GND), J2.A12 (GND), J2.B1 (GND), J2.B12 (GND), J2.S1 (SHIELD), J2.S2 (SHIELD), J2.S3 (SHIELD), J2.S4 (SHIELD), R1.1
unnamed: C2.1, D2.2 (A), D3.3 (G), R1.2
unnamed: D1.2 (A), R2.2

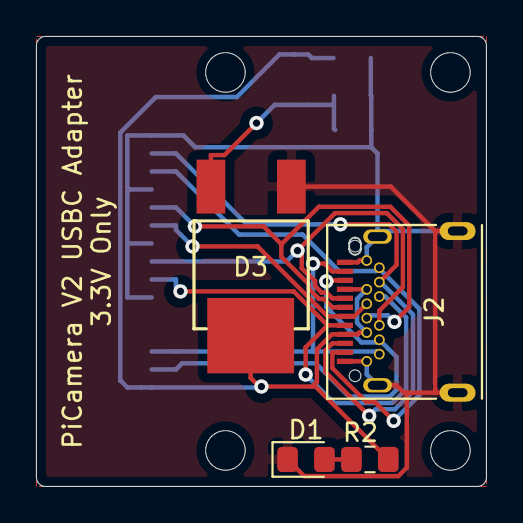
[picture p41: board Small Camera Adapter.kicad_pcb from above]

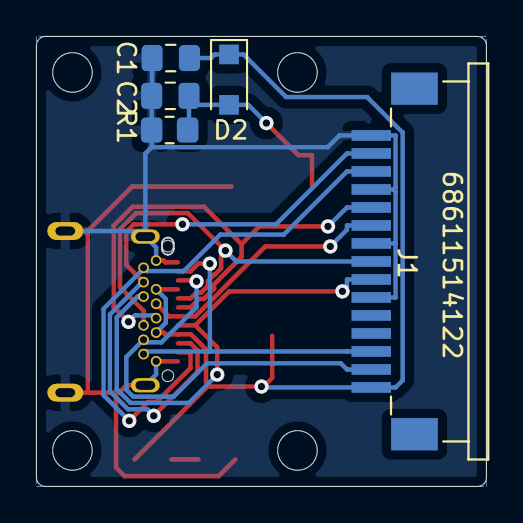
[picture p42: board Small Camera Adapter.kicad_pcb from below]

Board: 2 copper layers, 25.0 x 25.0 mm, 13 parts (5 on the bottom side), 12 nets.

Other parts of the board:
REF1, REF2, REF3, REF4: MountingHole_2.2mm_M2
