Yowie-Tool/Scanner-Dev/Line Generator/Line-generator-V2/Line-Generator-V2.kicad_pcb

## KiCad design Line Generator/Line-generator-V2/Line-Generator-V2.kicad_pcb (2021-02-12)

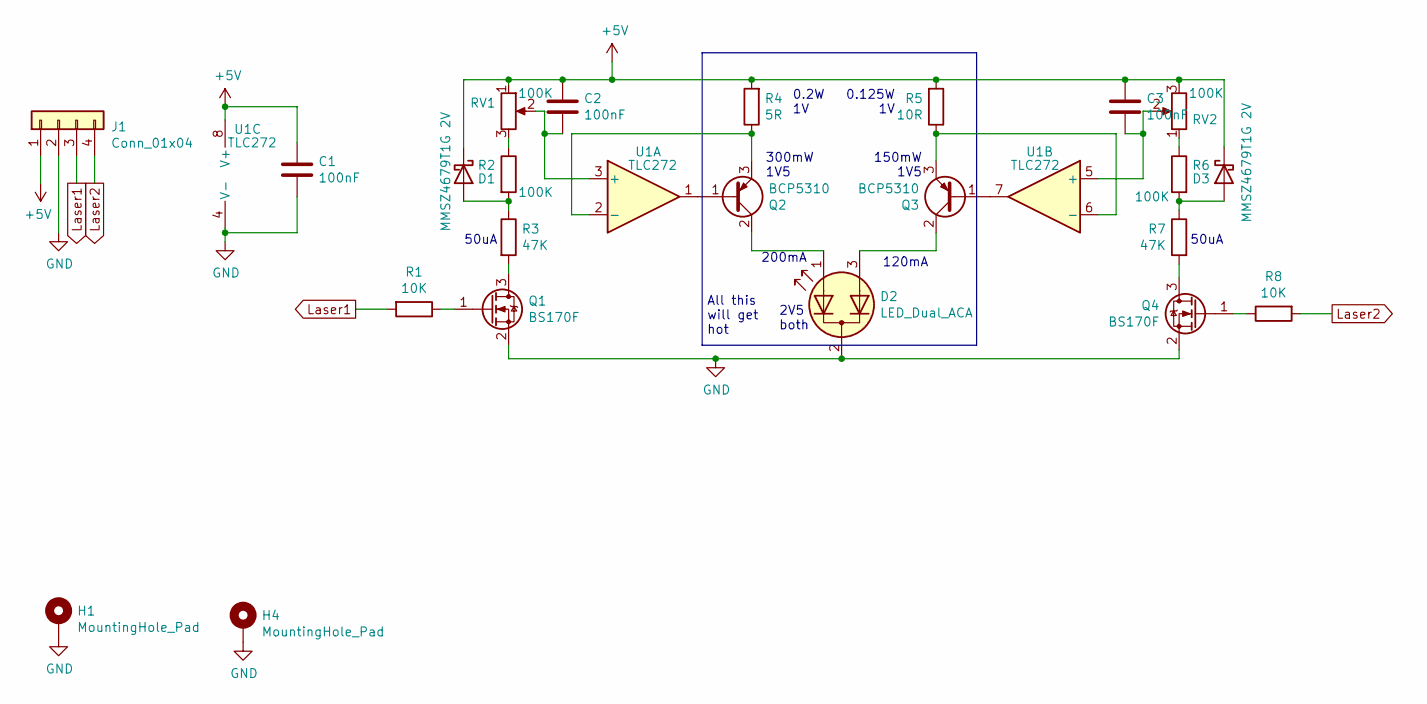
[picture p43: schematic Line-Generator-V2.sch]

Parts:
C1, C2, C3: 100nF; C_0805_2012Metric
D1, D3: MMSZ4679T1G 2V; D_SOD-123
D2: LED_Dual_ACA; PinSocket_1x03_P1.27mm_Vertical
H1, H4: MountingHole_Pad; MountingHole_3.2mm_M3_DIN965_Pad
J1: Conn_01x04; JST_XH_B4B-XH-A_1x04_P2.50mm_Vertical
Q1, Q4: BS170F; SOT-23
Q2, Q3: BCP5310; SOT-223-3_TabPin2
R1, R8: 10K; R_0805_2012Metric_Pad1.15x1.40mm_HandSolder
R2, R6: 100K; R_0805_2012Metric_Pad1.15x1.40mm_HandSolder
R3, R7: 47K; R_0805_2012Metric_Pad1.15x1.40mm_HandSolder
R4: 5R; R_Axial_DIN0207_L6.3mm_D2.5mm_P7.62mm_Horizontal
R5: 10R; R_Axial_DIN0207_L6.3mm_D2.5mm_P7.62mm_Horizontal
RV1, RV2: 100K; Potentiometer_Bourns_3386C_Horizontal
U1: TLC272; SOIC-8_3.9x4.9mm_P1.27mm

Connections:
+5V: C1.1, C2.1, C3.1, D1.1 (K), D3.1 (K), J1.1, R4.2, R5.2, RV1.1, RV2.3, U1.8 (V+)
GND: C1.2, D2.2 (K), H1.1, H4.1, J1.2, Q1.2 (S), Q4.2 (S), U1.4 (V-)
Laser1: J1.3, R1.2
Laser2: J1.4, R8.2
unnamed: C2.2, RV1.2, U1.3 (+)
unnamed: C3.2, RV2.2, U1.5 (+)
unnamed: D1.2 (A), R2.2, R3.1
unnamed: D2.1 (A1), Q2.2 (C)
unnamed: D2.3 (A2), Q3.2 (C)
unnamed: D3.2 (A), R6.2, R7.1
unnamed: Q1.1 (G), R1.1
unnamed: Q1.3 (D), R3.2
unnamed: Q2.1 (B), U1.1
unnamed: Q2.3 (E), R4.1, U1.2 (-)
unnamed: Q3.1 (B), U1.7
unnamed: Q3.3 (E), R5.1, U1.6 (-)
unnamed: Q4.1 (G), R8.1
unnamed: Q4.3 (D), R7.2
unnamed: R2.1, RV1.3
unnamed: R6.1, RV2.1

Notes on the sheet:
120mA
200mA
2V5 both
300mW 1V5
0.2W 1V
0.125W 1V
150mW 1V5
All this will get hot
50uA

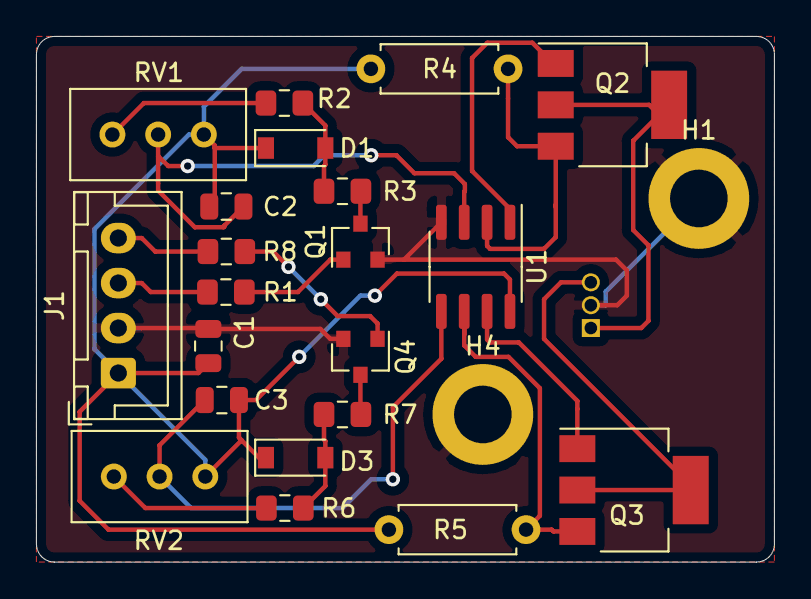
[picture p44: board Line-Generator-V2.kicad_pcb from above]

Board: 2 copper layers, 41.0 x 29.2 mm, 24 parts (1 on the bottom side), 20 nets.
