Yowie-Tool/Scanner-Dev/TempTopBoard/Temp Top Board.kicad_pcb

## KiCad design TempTopBoard/Temp Top Board.kicad_pcb (2020-09-21)

Schematic: Temp Top Board.sch, Camera Selection Board

Parts:
C1, C2: 100uF; CP_Radial_D8.0mm_P3.50mm
J1, J3: Conn_01x02; PinHeader_1x02_P2.54mm_Horizontal
J2, J6: Conn_01x05; JST_PH_B5B-PH-K_1x05_P2.00mm_Vertical
J4: Conn_01x04; JST_PH_B4B-PH-K_1x04_P2.00mm_Vertical
J5: Screw_Terminal_01x02; TerminalBlock_bornier-2_P5.08mm
J7: Conn_01x02; JST_XH_B2B-XH-A_1x02_P2.50mm_Vertical
J8: Conn_01x03; JST_PH_B3B-PH-K_1x03_P2.00mm_Vertical
J11, J12: Conn_01x02; JST_PH_B2B-PH-K_1x02_P2.00mm_Vertical
MK1, MK2, MK3, MK4: M2.5; MountingHole_2.7mm_M2.5
P1: Conn_02x20_Odd_Even; PinSocket_2x20_P2.54mm_Vertical
R1: 10K; R_0805_2012Metric_Pad1.15x1.40mm_HandSolder
R14, R15: 1K; R_0805_2012Metric_Pad1.15x1.40mm_HandSolder
U1: IRFML8244TRPBF; SOT95P240X112-3N
U2: LM7805_TO220; TO-220-3_Vertical

Connections:
+3V3: J2.1, P1.1, P1.17, R14.2, R15.2
+5V: C2.1, J1.1, J3.1, J7.1, U2.3 (VO)
+12V: C1.1, J4.1, J5.1, J6.1, J8.1, U2.1 (VI)
CAMERAGPIO: J8.2
GND: C1.2, C2.2, J1.2, J2.5, J3.2, J4.2, J5.2, J6.5, J8.3, P1.6, P1.9, P1.14, P1.20, P1.25, P1.30, P1.34, P1.39, U1.2 (S), U2.2 (GND)
LASER1: J4.3, P1.29
LASER2: J4.4, P1.31
LASER3: P1.33, R1.2
unnamed: J7.2, U1.3 (D)
unnamed: J11.2, R14.1
unnamed: J12.2, R15.1
unnamed: R1.1, U1.1 (G)
OE1: J2.3, P1.16
OE2: J2.4, P1.12
REED: J11.1, P1.35
SEL: J2.2, P1.18
SWITCH: J12.1, P1.37
Uart0RX: J6.3, P1.10
Uart0TX: J6.2, P1.8
UartRESET: J6.4

Notes on the sheet:
Mounting Holes
Pi Header (Extra Long pins)
Laser 1/2
Stepper Control 1
Reed Switch
Power Switch
Camera 0/1 Power
12V power
External Camera Switcher

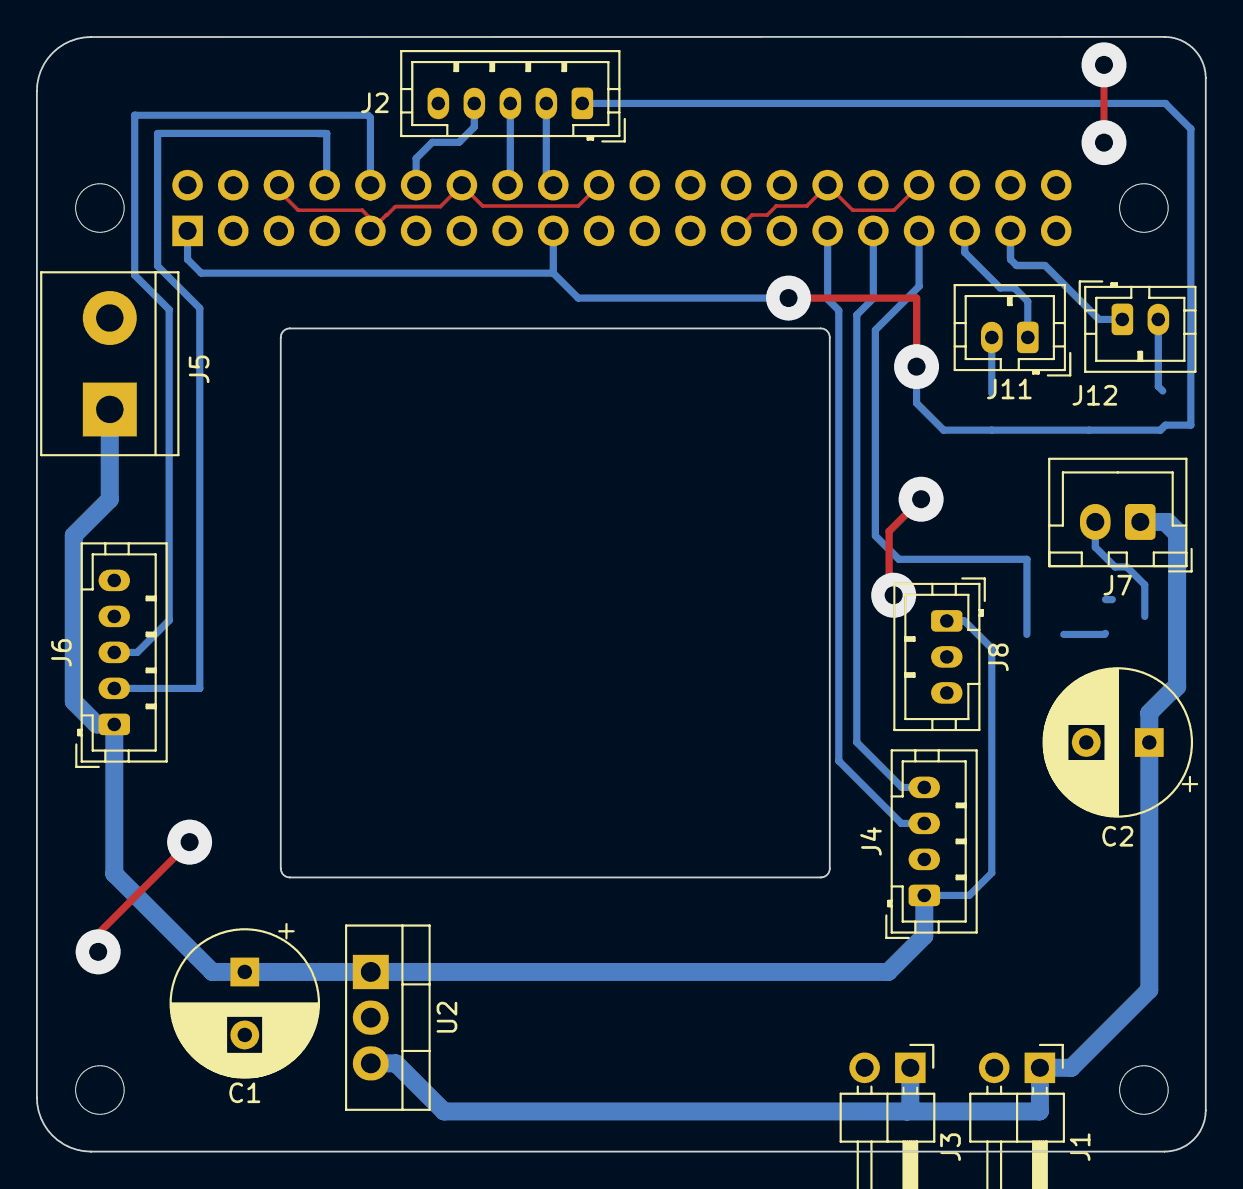
[picture p45: board Temp Top Board.kicad_pcb from above]

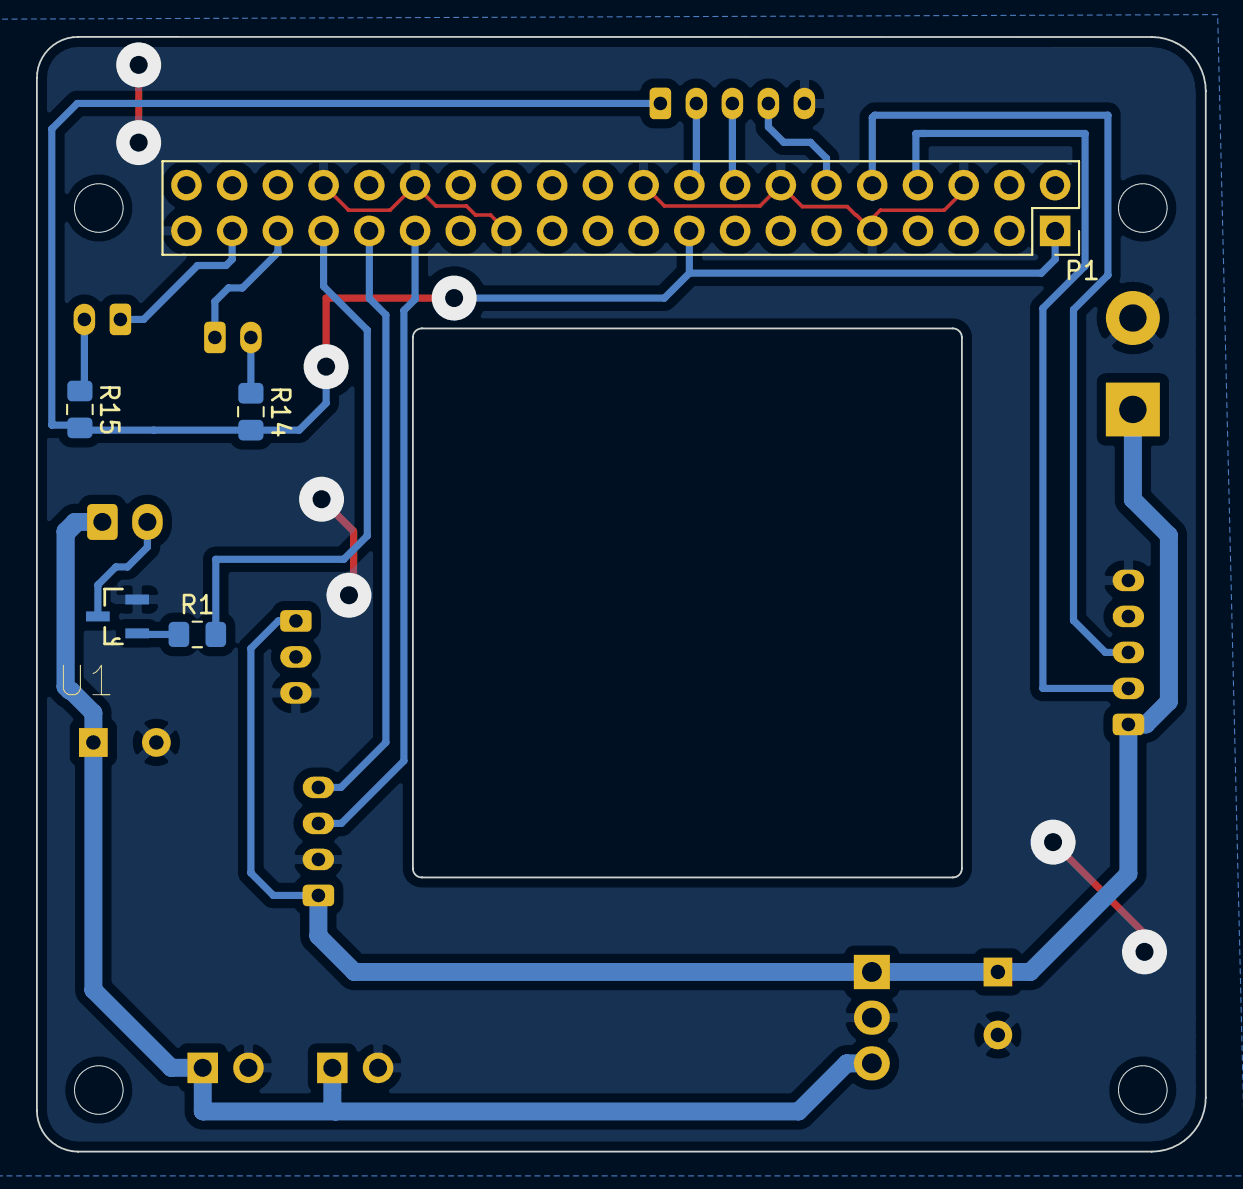
[picture p46: board Temp Top Board.kicad_pcb from below]

Board: 2 copper layers, 64.9 x 61.9 mm, 22 parts (5 on the bottom side), 18 nets.
