Yowie-Tool/Scanner-Dev/New Top Board/Top Board.kicad_pcb

## KiCad design New Top Board/Top Board.kicad_pcb (2020-09-11)

Schematic: Top Board.sch, Camera Selection Board

Parts:
C1, C2, C3, C4, C5: 10nF; C_0603_1608Metric_Pad1.05x0.95mm_HandSolder
J1, J4, J10: Conn_01x04; JST_PH_B4B-PH-K_1x04_P2.00mm_Vertical
J2: 68611514122
J3: Conn_01x06; JST_PH_B6B-PH-K_1x06_P2.00mm_Vertical
J5: Screw_Terminal_01x02; TerminalBlock_bornier-2_P5.08mm
J6, J7: Conn_01x05; JST_PH_B5B-PH-K_1x05_P2.00mm_Vertical
J8, J9: Conn_01x03; JST_PH_B3B-PH-K_1x03_P2.00mm_Vertical
J11, J12: Conn_01x02; JST_PH_B2B-PH-K_1x02_P2.00mm_Vertical
J13, J14: RJE392881400; Mouser Part Number 523-RJE392881400
MK1, MK2, MK3, MK4: M2.5; MountingHole_2.7mm_M2.5
P1: Conn_02x20_Odd_Even; PinSocket_2x20_P2.54mm_Vertical
R11, R12, R13: 10K; R_0805_2012Metric_Pad1.15x1.40mm_HandSolder
R14, R15: 1K; R_0603_1608Metric_Pad1.05x0.95mm_HandSolder
RN1, RN2: 10K; R_Array_Convex_4x1206
U2: LTC4314; SOP65P777X199-20N; MPN LTC4314
U3, U7: FSA642; FSA642UMX; MPN FSA642
U5: MC14555BCPG; SOIC127P600X175-16N

Connections:
5VPROTECTED: P1.2, P1.4
+3V3: C1.1, C2.1, C3.1, C4.1, C5.1, J3.1, J3.5, J10.1, P1.1, P1.17, R11.2, R12.1, R13.1, R14.2, R15.2, RN1.1 (R1.1), RN1.2 (R2.1), RN1.3 (R3.1), RN1.4 (R4.1), RN2.5 (R4.2), RN2.6 (R3.2), RN2.7 (R2.2), RN2.8 (R1.2), U2.1 (DISCEN), U2.2 (VCC), U2.16 (VCC2), U2.20 (~ACC), U3.10 (VCC), U5.16 (VDD), U7.10 (VCC)
+12V: J1.1, J4.1, J5.1, J6.1, J7.1, J8.1, J9.1
CAMERA0CN: J13.5, U3.16 (CLKAN)
CAMERA0CP: J13.6, U3.17 (CLKAP)
CAMERA0DN0: J13.3, U3.14 (DA1N)
CAMERA0DN1: J13.1, U3.12 (DA2N)
CAMERA0DP0: J13.4, U3.15 (DA1P)
CAMERA0DP1: J13.2, U3.13 (DA2P)
CAMERA0SCL: J13.7, R13.2, U2.3 (SCLOUT1)
CAMERA0SDA: J13.8, R12.2, U2.4 (SDAOUT1)
CAMERA1CN: J13.13, U3.23 (CLKBN)
CAMERA1CP: J13.14, U3.22 (CLKBP)
CAMERA1DN0: J13.11, U3.21 (DB1N)
CAMERA1DN1: J13.9, U3.18 (DB2N)
CAMERA1DP0: J13.12, U3.20 (DB1P)
CAMERA1DP1: J13.10, U3.19 (DB2P)
CAMERA1SCL: J13.15, RN2.3 (R3.1), U2.7 (SCLOUT2)
CAMERA1SDA: J13.16, RN2.4 (R4.1), U2.8 (SDAOUT2)
CAMERA2CN: J14.5, U7.16 (CLKAN)
CAMERA2CP: J14.6, U7.17 (CLKAP)
CAMERA2DN0: J14.3, U7.14 (DA1N)
CAMERA2DN1: J14.1, U7.12 (DA2N)
CAMERA2DP0: J14.4, U7.15 (DA1P)
CAMERA2DP1: J14.2, U7.13 (DA2P)
CAMERA2SCL: J14.7, R11.1, U2.13 (SCLOUT3)
CAMERA2SDA: J14.8, RN1.5 (R4.2), U2.14 (SDAOUT3)
CAMERA3CN: J14.13, U7.23 (CLKBN)
CAMERA3CP: J14.14, U7.22 (CLKBP)
CAMERA3DN0: J14.11, U7.21 (DB1N)
CAMERA3DN1: J14.9, U7.18 (DB2N)
CAMERA3DP0: J14.12, U7.20 (DB1P)
CAMERA3DP1: J14.10, U7.19 (DB2P)
CAMERA3SCL: J14.15, RN1.7 (R2.2), U2.17 (SCLOUT4)
CAMERA3SDA: J14.16, RN1.8 (R1.2), U2.18 (SDAOUT4)
CAMERACN: J2.8, U3.2 (CLKN), U7.2 (CLKN)
CAMERACP: J2.7 (9), U3.1 (CLKP), U7.1 (CLKP)
CAMERADN0: J2.14 (2), U3.4 (D1N), U7.4 (D1N)
CAMERADN1: J2.11 (5), U3.6 (D2N), U7.6 (D2N)
CAMERADP0: J2.13 (3), U3.3 (D1P), U7.3 (D1P)
CAMERADP1: J2.10 (6), U3.5 (D2P), U7.5 (D2P)
CAMERAGPIO: J2.5 (11), J8.2, J9.2
CAMERASCL: J2.3 (13), RN2.2 (R2.1), U2.6 (SCLIN)
CAMERASDA: J2.2 (14), RN2.1 (R1.1), U2.5 (SDAIN)
ENABLE1: U2.12 (ENABLE1), U5.4 (Q0A)
ENABLE2: U2.11 (ENABLE2), U5.5 (Q1A)
ENABLE3: U2.10 (ENABLE3), U5.6 (Q2A)
ENABLE4: U2.9 (ENABLE4), U5.7 (Q3A)
GND: C1.2, C2.2, C3.2, C4.2, C5.2, J1.2, J2.6 (10), J2.9 (7), J2.12 (4), J2.15 (1), J3.2, J4.2, J5.2, J6.5, J7.5, J8.3, J9.3, J10.4, J13.MH1, J13.MH2, J14.MH1, J14.MH2, P1.6, P1.9, P1.14, P1.20, P1.25, P1.30, P1.34, P1.39, U2.19 (GND), U3.9 (GND), U5.1 (~EA~), U5.8 (VSS), U5.13 (BB), U5.14 (AB), U7.9 (GND)
INTERRUPT: J3.6, P1.22
LASER1: J4.3, P1.15
LASER2: J4.4, P1.16
LASER3: J1.3, P1.26
LASER4: J1.4, P1.36
unnamed: J11.2, R14.1
unnamed: J12.2, R15.1
OE1: P1.11, U3.8 (/OE), U5.3 (BA), U5.15 (~EB~)
OE1I: U5.12 (Q0B), U7.8 (/OE)
REED: J11.1, P1.35
SCL: J3.3, P1.5
SDA: J3.4, P1.3
SEL: P1.12, U3.11 (SEL), U5.2 (AA), U7.11 (SEL)
SWITCH: J12.1, P1.37
SWITCHFAULT: P1.38, RN1.6 (R3.2), U2.15 (~FAULT)
Spi0CE0: P1.24
Spi0MISO: P1.21
Spi0MOSI: P1.19
Spi0SCLK: P1.23
Uart0RX: J6.3, P1.10
Uart0TX: J6.2, P1.8
Uart3RX: J10.3
Uart3TX: J10.2, P1.7, P1.29
Uart5RX: J7.3, P1.33
Uart5TX: J7.2, P1.32
UartRESET: J6.4, J7.4, P1.18

Notes on the sheet:
Mounting Holes
Pi Header (Extra Long pins)
Laser 1/2
Laser 3/4
Logic circuit
Stepper Control 2
Stepper Control 1
Camera Out
Camera 0/1 in
Camera 2/3 in
Reed Switch
Power Switch
Additional UART control (GPS)
Camera 0/1 Power
Camera 2/3 Power
MPU6050 External
12V power

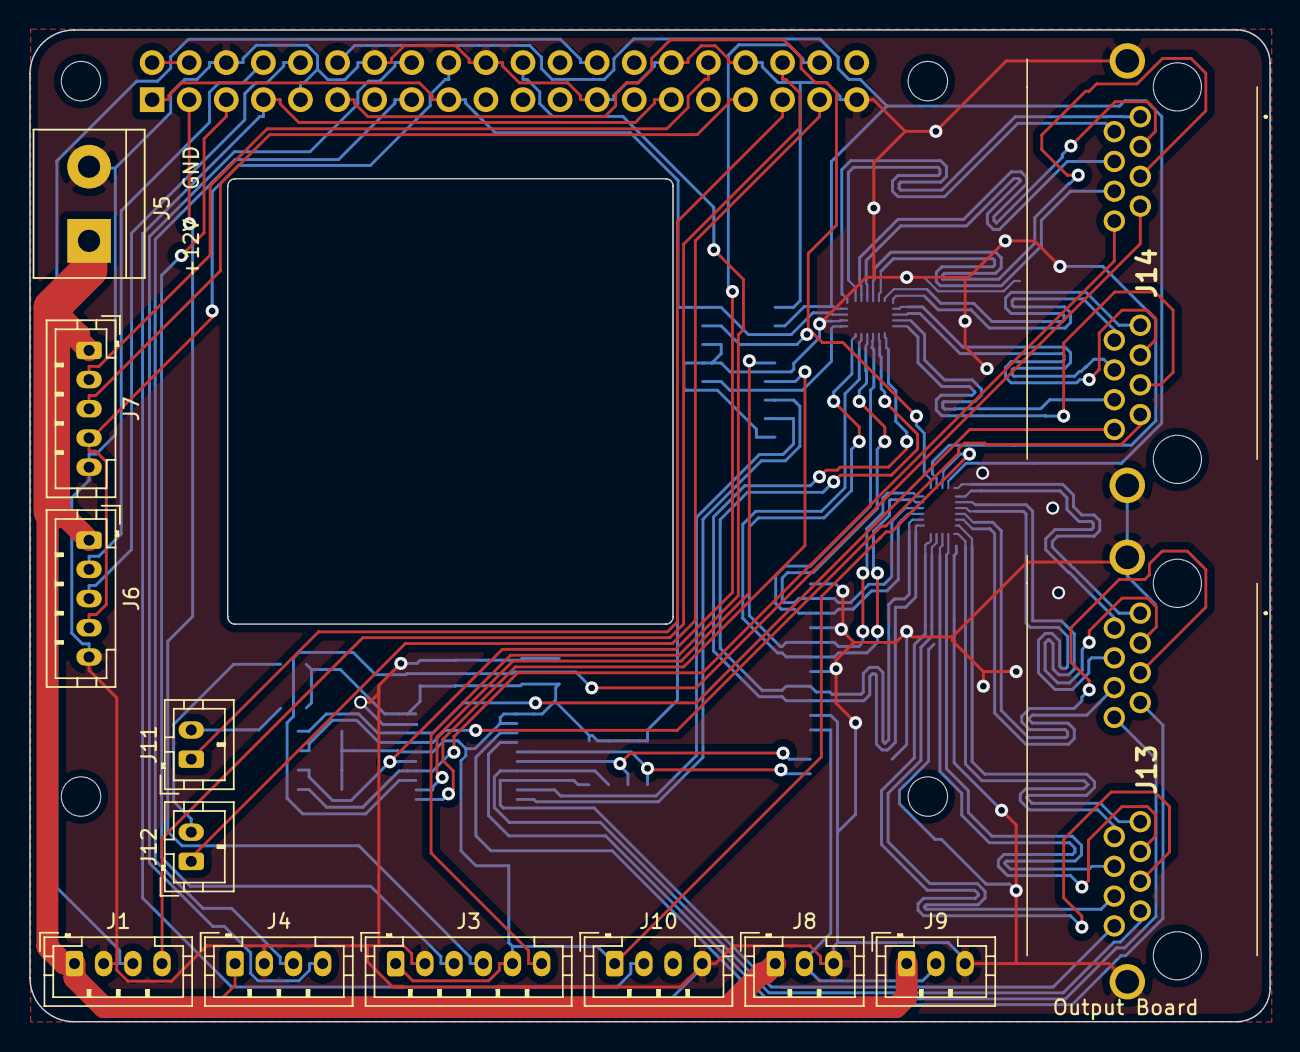
[picture p47: board Top Board.kicad_pcb from above]

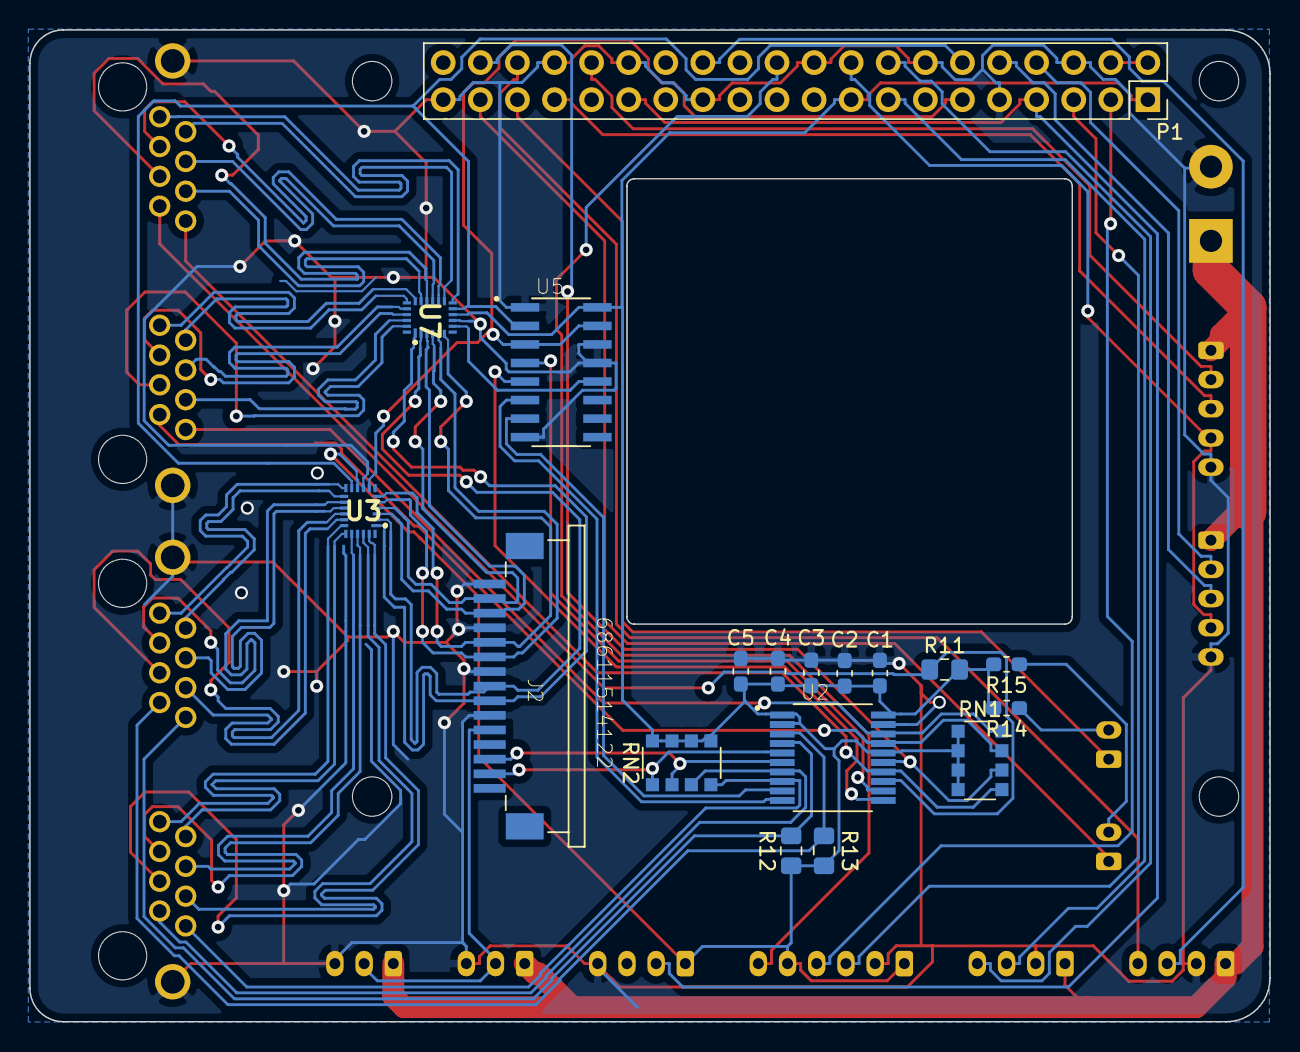
[picture p48: board Top Board.kicad_pcb from below]

Board: 2 copper layers, 84.9 x 67.9 mm, 35 parts (18 on the bottom side), 70 nets.
