Yowie-Tool/Scanner-Dev/Stepper motor controller/Stepper motor controller V2.kicad_pcb

## KiCad design Stepper motor controller/Stepper motor controller V2.kicad_pcb (2020-06-26)

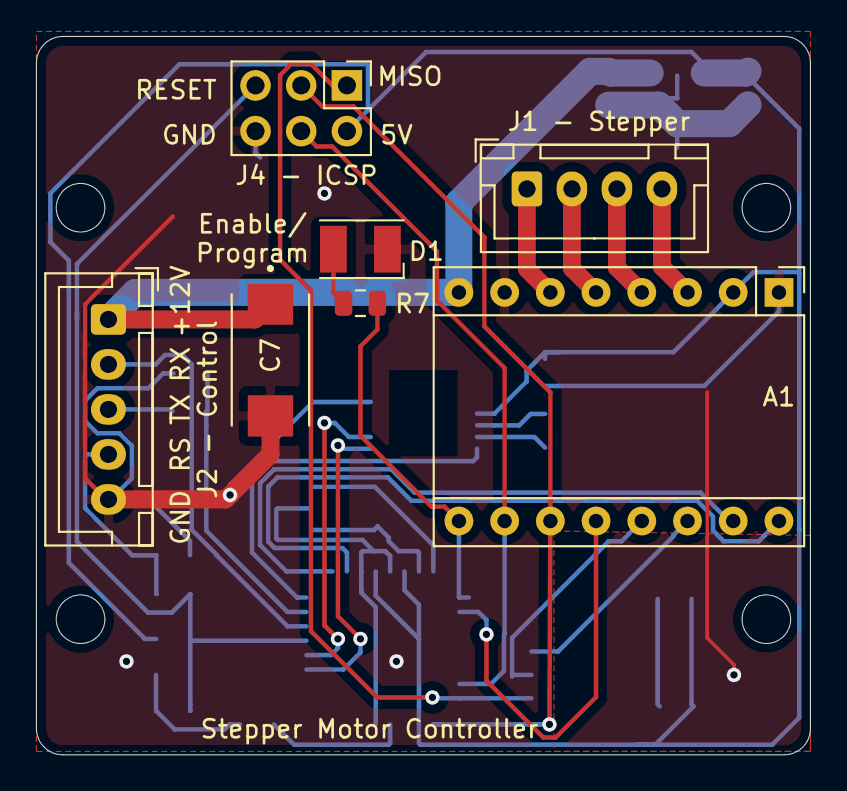
[picture p49: board Stepper motor controller V2.kicad_pcb from above]

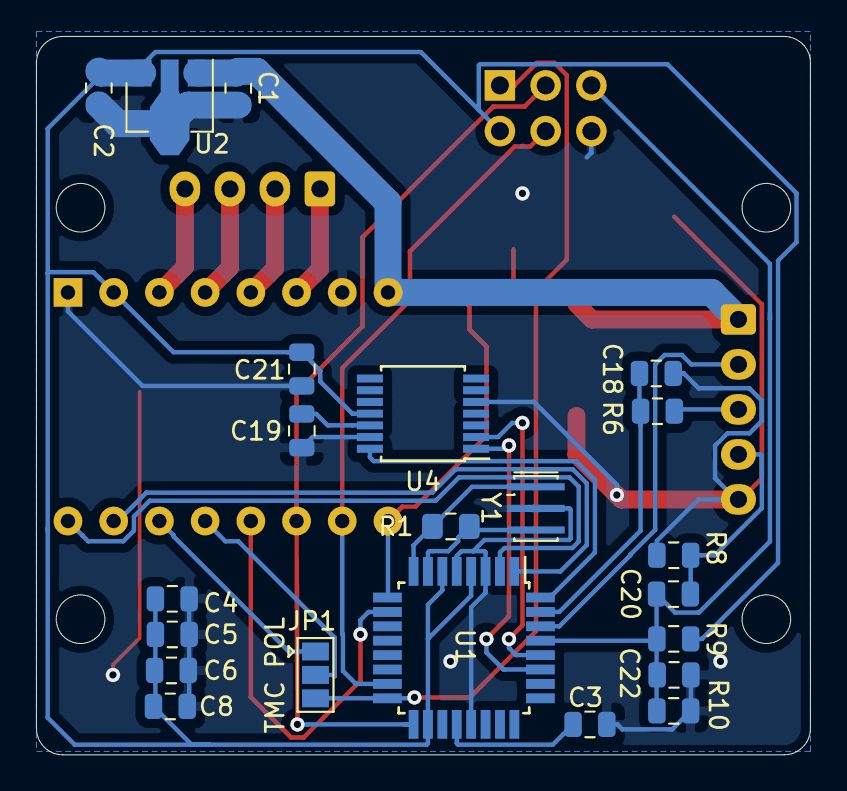
[picture p50: board Stepper motor controller V2.kicad_pcb from below]

Board: 2 copper layers, 43.0 x 39.9 mm, 33 parts (22 on the bottom side), 29 nets.

Parts:
A1: Pololu_Breakout_A4988; Pololu_Breakout-16_15.2x20.3mm
C1: 1.0uF; C_0805_2012Metric
C2: 2.2uF; C_0805_2012Metric
C3, C4, C5, C6, C8, C20, C21, C22: 0.1uF; C_0805_2012Metric
C7: 100uF; CAPPM7343X310N
C18: 470pF; C_0805_2012Metric
C19: 10uF; C_0805_2012Metric
D1: LED; LED_PLCC-2
J1 - Stepper: Conn_01x04; JST_XH_B4B-XH-A_1x04_P2.50mm_Vertical
J2 - Control: Conn_01x05; JST_XH_B5B-XH-A_1x05_P2.50mm_Vertical
J4 - ICSP: AVR-ISP-6; PinHeader_2x03_P2.54mm_Vertical
JP1: SolderJumper_3_Open; SolderJumper-3_P1.3mm_Open_Pad1.0x1.5mm
MOUNT1, MOUNT2, MOUNT3, MOUNT4: MountingHole_2.7mm_M2.5_ISO7380
R1: 1M; R_0805_2012Metric_Pad1.15x1.40mm_HandSolder
R6: 270R; R_0805_2012Metric
R7, R8, R9, R10: 10K; R_0805_2012Metric
U1: ATmega328P-AU; TQFP-32_7x7mm_P0.8mm
U2: AP2204R-5.0; SOT-89-3
U4: AS5048B; TSSOP-14_4.4x5mm_P0.65mm
Y1: Crystal_GND2; Resonator_SMD_muRata_CSTxExxV-3Pin_3.0x1.1mm_HandSoldering

Connections:
+5V: A1.2, C2.1, C4.2, C5.2, C6.2, C8.2, C21.2, J4 - ICSP.2, R9.2, U1.4, U1.6, U1.18, U2.3, U4.11
+12V: A1.8, C1.1, C7.1, J2 - Control.1, U2.1
CS: A1.12, U1.10
DIR: A1.16, U1.2
ENABLE: A1.9, R7.1, U1.9
GND: A1.1, A1.7, C1.2, C2.2, C3.2, C4.1, C5.1, C6.1, C7.2, C8.1, C18.2, C19.2, C21.1, C22.2, D1.1, J2 - Control.5, J4 - ICSP.6, R8.1, R10.1, U1.3, U1.5, U1.21, U2.2, U4.5, U4.13, Y1.2
MISO: J4 - ICSP.1, JP1.3, U1.16
MOSI: A1.10, J4 - ICSP.4, U1.15
unnamed: A1.13, JP1.2
unnamed: A1.14, JP1.1
unnamed: C3.1, U1.20
unnamed: C19.1, U4.12
unnamed: D1.2, R7.2
unnamed: R1.1, U1.7, Y1.3
unnamed: R1.2, U1.8, Y1.1
OA1: A1.4, J1 - Stepper.3
OA2: A1.5, J1 - Stepper.2
OB1: A1.3, J1 - Stepper.4
OB2: A1.6, J1 - Stepper.1
PWM: A1.15, U1.1
PWMin: U1.32, U4.14
RESET: C20.2, C22.1, J4 - ICSP.5, R9.1, R10.2, U1.29
RESETin: C20.1, J2 - Control.4, R8.2
RX: J2 - Control.2, U1.30
SCK: A1.11, J4 - ICSP.3, U1.17
SCL: U1.28, U4.2
SDA: U1.27, U4.1
TX: C18.1, R6.1, U1.31
TXin: J2 - Control.3, R6.2
