Yowie-Tool/Scanner-Dev/Universal Interface Board/Universal Interface Board - Copy.kicad_pcb

## KiCad design Universal Interface Board/Universal Interface Board - Copy.kicad_pcb (2020-06-26)

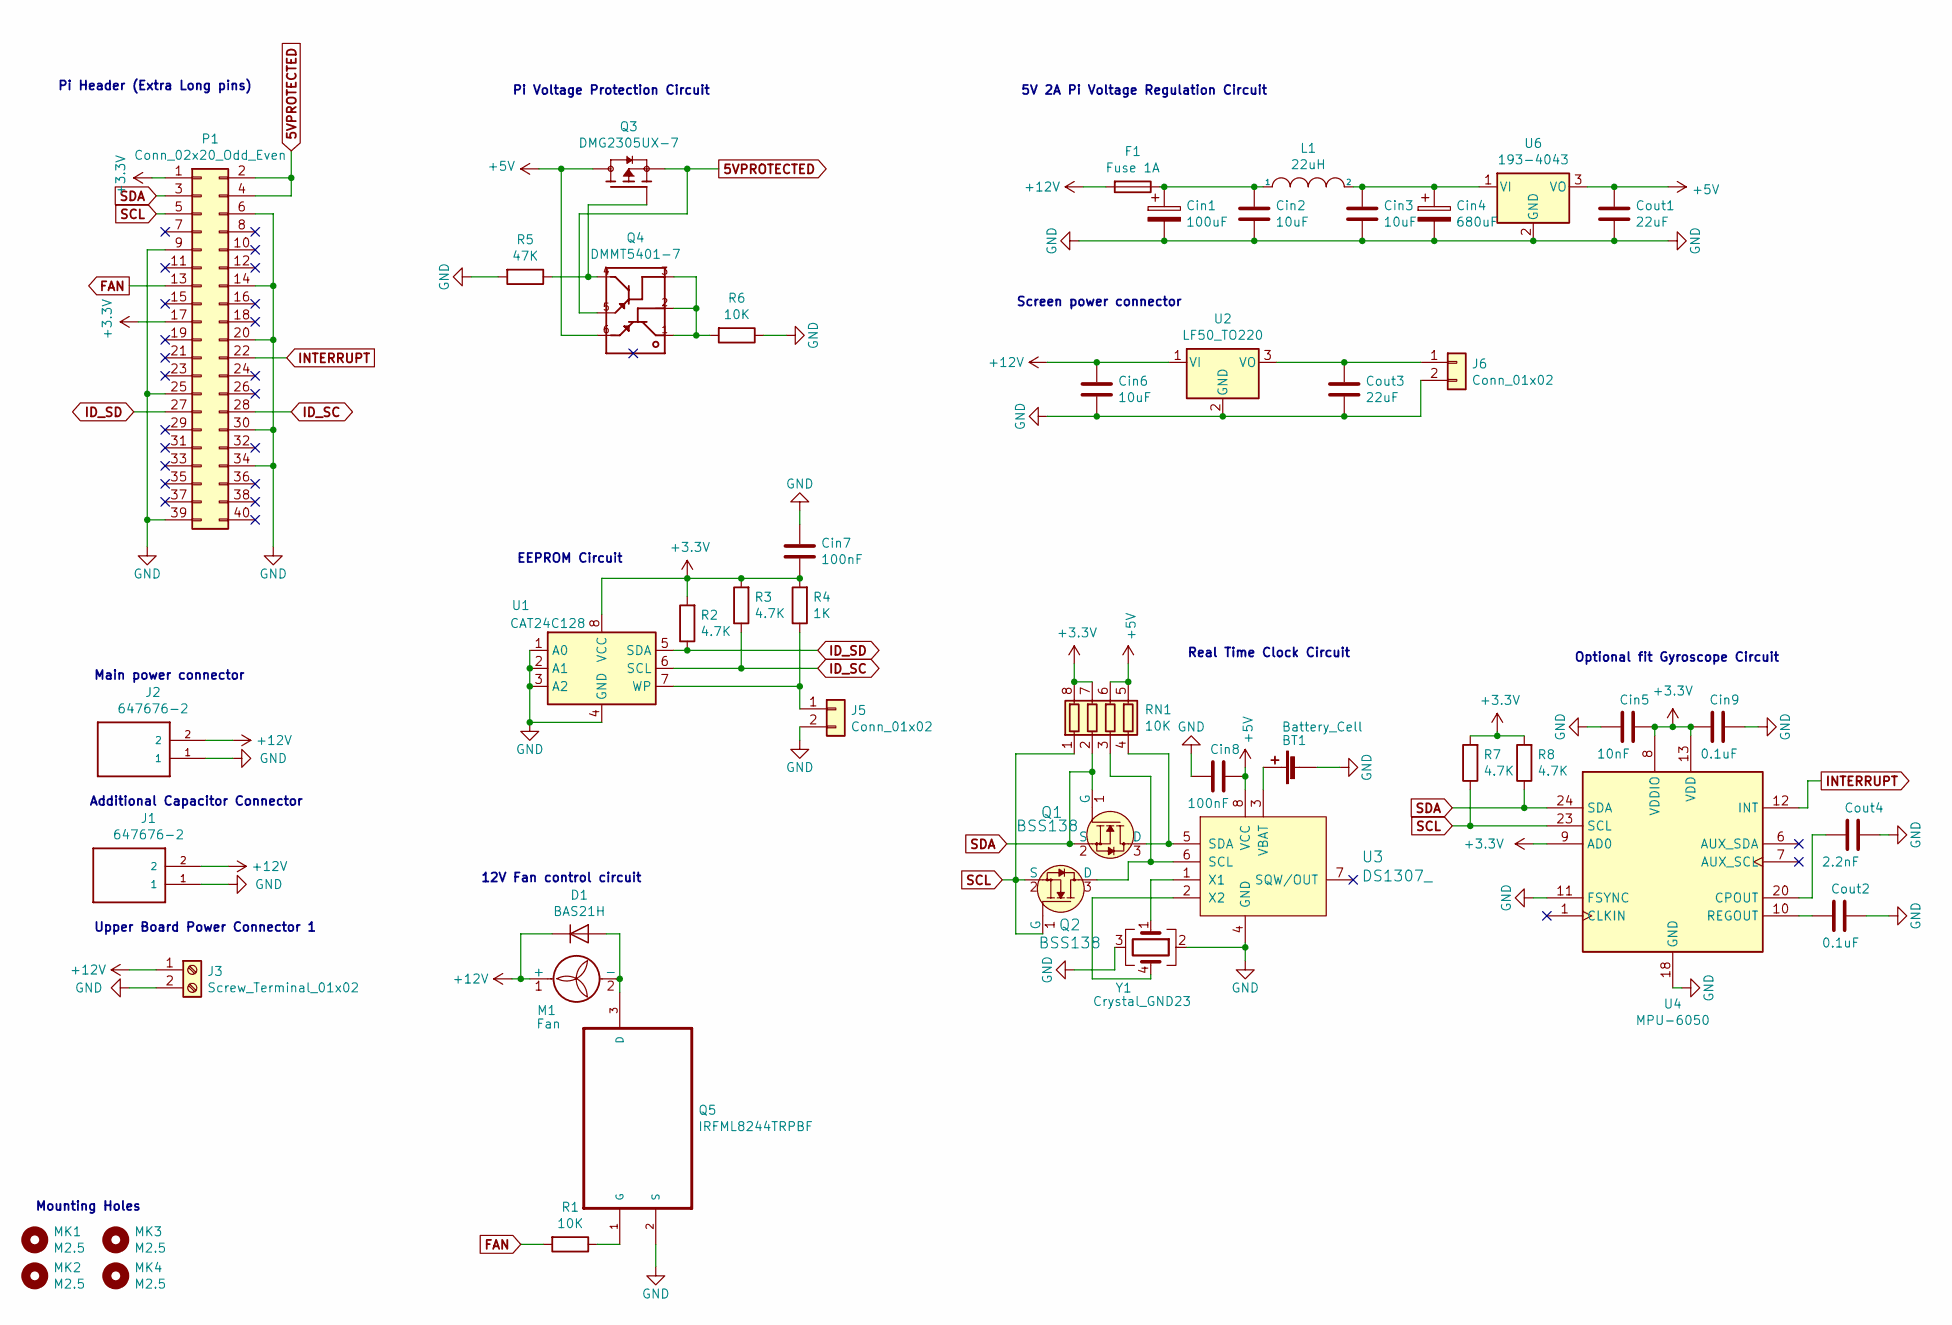
[picture p51: schematic Universal Interface Board - Copy.sch, Universal Interface Board]

Parts:
BT1: Battery_Cell; BatteryHolder_Keystone_3001_1x12mm
Cin1: 100uF; CP_Radial_D6.3mm_P2.50mm
Cin2, Cin3, Cin6: 10uF; C_1206_3216Metric_Pad1.42x1.75mm_HandSolder
Cin4: 680uF; CP_Radial_D10.0mm_P5.00mm
Cin5: 10nF; C_0603_1608Metric_Pad1.05x0.95mm_HandSolder
Cin7, Cin8: 100nF; C_0603_1608Metric_Pad1.05x0.95mm_HandSolder
Cin9: 0.1uF; C_0805_2012Metric_Pad1.15x1.40mm_HandSolder
Cout1, Cout3: 22uF; C_1210_3225Metric_Pad1.42x2.65mm_HandSolder
Cout2: 0.1uF; C_0805_2012Metric_Pad1.15x1.40mm_HandSolder
Cout4: 2.2nF; C_0603_1608Metric_Pad1.05x0.95mm_HandSolder
D1: BAS21H; D_SOD-123F
F1: Fuse 1A; Fuse_Littelfuse_395Series
J1, J2: 647676-2; TE_647676-2
J3: Screw_Terminal_01x02; TerminalBlock_bornier-2_P5.08mm
J5: Conn_01x02; PinHeader_1x02_P2.54mm_Vertical
J6: Conn_01x02; PinHeader_1x02_P2.54mm_Horizontal
L1: 22uH; L_Wuerth_HCI-7050
M1: Fan; SolderWirePad_1x02_P3.81mm_Drill1mm
MK1, MK2, MK3, MK4: M2.5; MountingHole_2.7mm_M2.5
P1: Conn_02x20_Odd_Even; PinSocket_2x20_P2.54mm_Vertical
Q1, Q2: BSS138; SOT-23-3; MPN BSS138; Digi-Key_PN BSS138CT-ND
Q3: DMG2305UX-7; SOT91P240X110-3N_DMG2305UX-7
Q4: DMMT5401-7; SOT26
Q5: IRFML8244TRPBF; SOT-23
R1: 10K; R_0603_1608Metric_Pad1.05x0.95mm_HandSolder
R2, R3, R7, R8: 4.7K; R_0603_1608Metric_Pad1.05x0.95mm_HandSolder
R4: 1K; R_0603_1608Metric_Pad1.05x0.95mm_HandSolder
R5: 47K; R_0603_1608Metric_Pad1.05x0.95mm_HandSolder
R6: 10K; R_0805_2012Metric_Pad1.15x1.40mm_HandSolder
RN1: 10K; R_Array_Convex_4x1206
U1: CAT24C128; SOIC-8_3.9x4.9mm_P1.27mm
U2: LF50_TO220; DPAK
U3: DS1307_; SOIC-8_3.9x4.9mm_P1.27mm; MPN DS1307+; Digi-Key_PN DS1307+-ND
U4: MPU-6050; InvenSense_QFN-24_4x4mm_P0.5mm
U6: 193-4043
Y1: Crystal_GND23; Crystal_SMD_Abracon_ABS25-4Pin_8.0x3.8mm

Connections:
5VPROTECTED: P1.2, P1.4, Q3.2 (S), Q4.5 (E2)
+3V3: Cin5.1, Cin7.2, Cin9.2, P1.1, P1.17, R2.2, R3.2, R4.2, R7.2, R8.2, RN1.7 (R2.2), RN1.8 (R1.2), U1.8 (VCC), U4.8 (VDDIO), U4.9 (AD0), U4.13 (VDD)
+5V: Cin8.1, Cout1.1, Q3.3 (D), Q4.6 (E1), RN1.5 (R4.2), RN1.6 (R3.2), U3.8 (VCC), U6.3 (VO)
+12V: Cin6.1, D1.1 (K), F1.2, J1.2, J2.2, J3.1, M1.1 (+), U2.1 (VI)
FAN: P1.13, R1.2
GND: BT1.2 (-), Cin1.2, Cin2.2, Cin3.2, Cin4.2, Cin5.2, Cin6.2, Cin7.1, Cin8.2, Cin9.1, Cout1.2, Cout2.1, Cout3.2, Cout4.1, J1.1, J2.1, J3.2, J5.2, J6.2, P1.6, P1.9, P1.14, P1.20, P1.25, P1.30, P1.34, P1.39, Q5.2 (S), R5.2, R6.1, U1.1 (A0), U1.2 (A1), U1.3 (A2), U1.4 (GND), U2.2 (GND), U3.4 (GND), U4.11 (FSYNC), U4.18 (GND), U6.2 (GND), Y1.2, Y1.3
ID_SC: P1.28, R3.1, U1.6 (SCL)
ID_SD: P1.27, R2.1, U1.5 (SDA)
INTERRUPT: P1.22, U4.12 (INT)
unnamed: BT1.1 (+), U3.3 (VBAT)
unnamed: Cin1.1, Cin2.1, F1.1, L1.1
unnamed: Cin3.1, Cin4.1, L1.2, U6.1 (VI)
unnamed: Cout2.2, U4.10 (REGOUT)
unnamed: Cout3.1, J6.1, U2.3 (VO)
unnamed: Cout4.2, U4.20 (CPOUT)
unnamed: D1.2 (A), M1.2 (-), Q5.3 (D)
unnamed: J5.1, R4.1, U1.7 (WP)
unnamed: Q1.3 (D), RN1.4 (R4.1), U3.5 (SDA)
unnamed: Q2.3 (D), RN1.3 (R3.1), U3.6 (SCL)
unnamed: Q3.1 (G), Q4.4 (C2), R5.1
unnamed: Q4.1 (C1), Q4.2 (B1), Q4.3 (B2), R6.2
unnamed: Q5.1 (G), R1.1
unnamed: U3.1 (X1), Y1.1
unnamed: U3.2 (X2), Y1.4
SCL: P1.5, Q2.1 (G), Q2.2 (S), R7.1, RN1.1 (R1.1), U4.23 (SCL)
SDA: P1.3, Q1.1 (G), Q1.2 (S), R8.1, RN1.2 (R2.1), U4.24 (SDA)

Notes on the sheet:
Mounting Holes
Pi Header (Extra Long pins)
Pi Voltage Protection Circuit
5V 2A Pi Voltage Regulation Circuit
Real Time Clock Circuit
Main power connector
Additional Capacitor Connector
12V Fan control circuit
Upper Board Power Connector 1
Screen power connector
EEPROM Circuit
Optional fit Gyroscope Circuit
