Yowie-Tool/Scanner-Dev/Universal Interface Board/Universal Interface Board - Copy.kicad_pcb

## KiCad design Universal Interface Board/Universal Interface Board - Copy.kicad_pcb (continued)

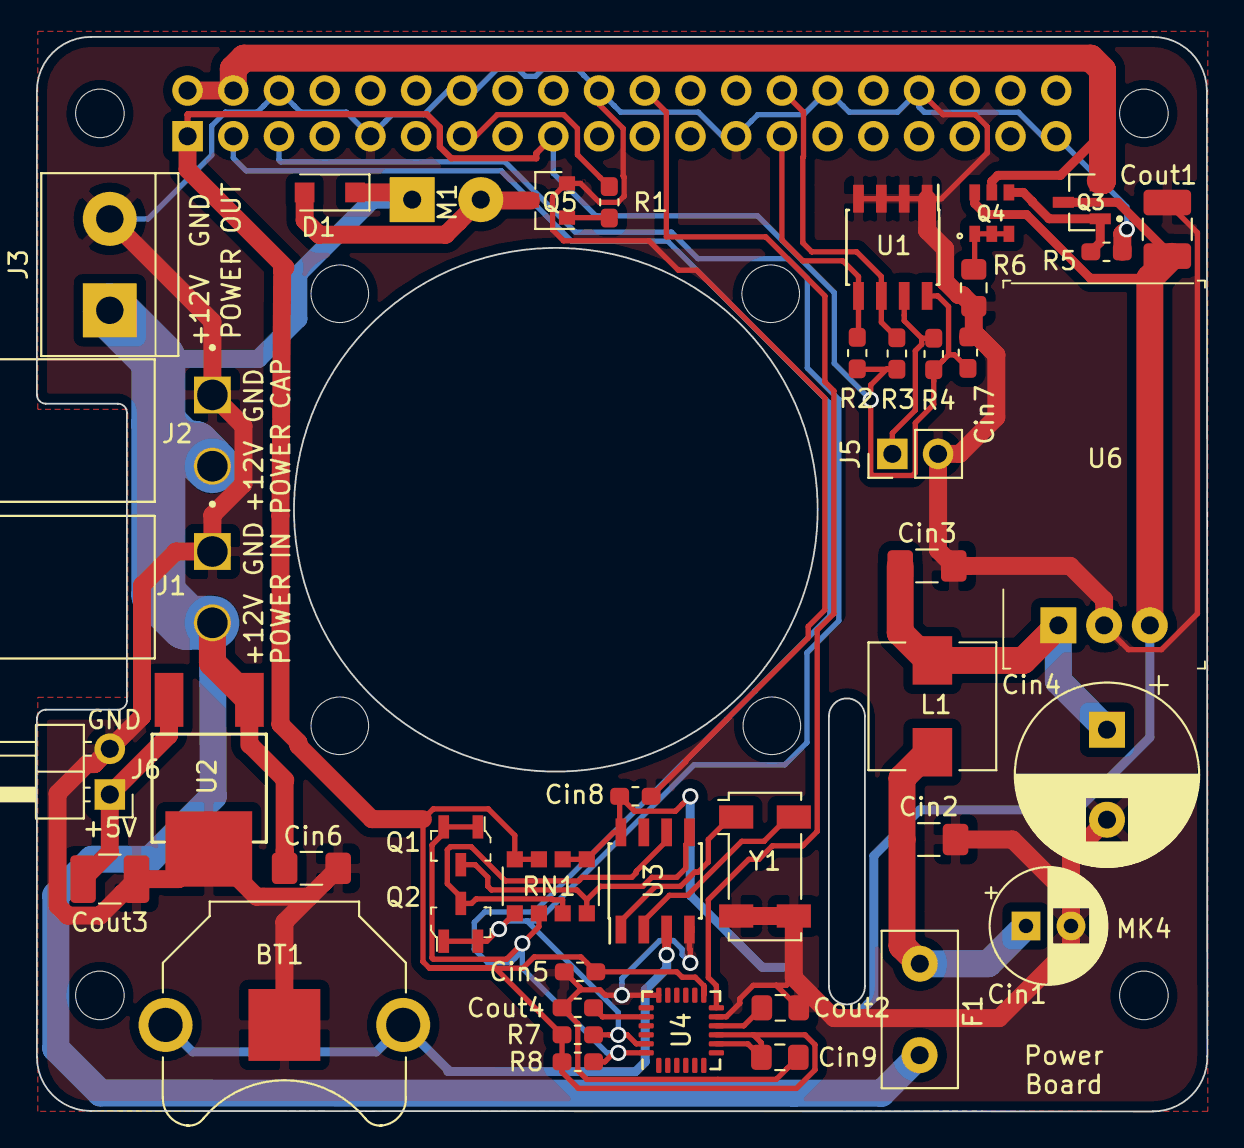
[picture p52: board Universal Interface Board - Copy.kicad_pcb from above]

Board: 2 copper layers, 65.0 x 59.7 mm, 52 parts (1 on the bottom side), 26 nets.

Other parts of the board:
Fan1, Fan2, Fan3, Fan4: MountingHole_3.2mm_M3_ISO14580
