Yowie-Tool/Scanner-Dev/Camera Adapter/Camera Adapter.kicad_pcb

## KiCad design Camera Adapter/Camera Adapter.kicad_pcb (2020-04-05)

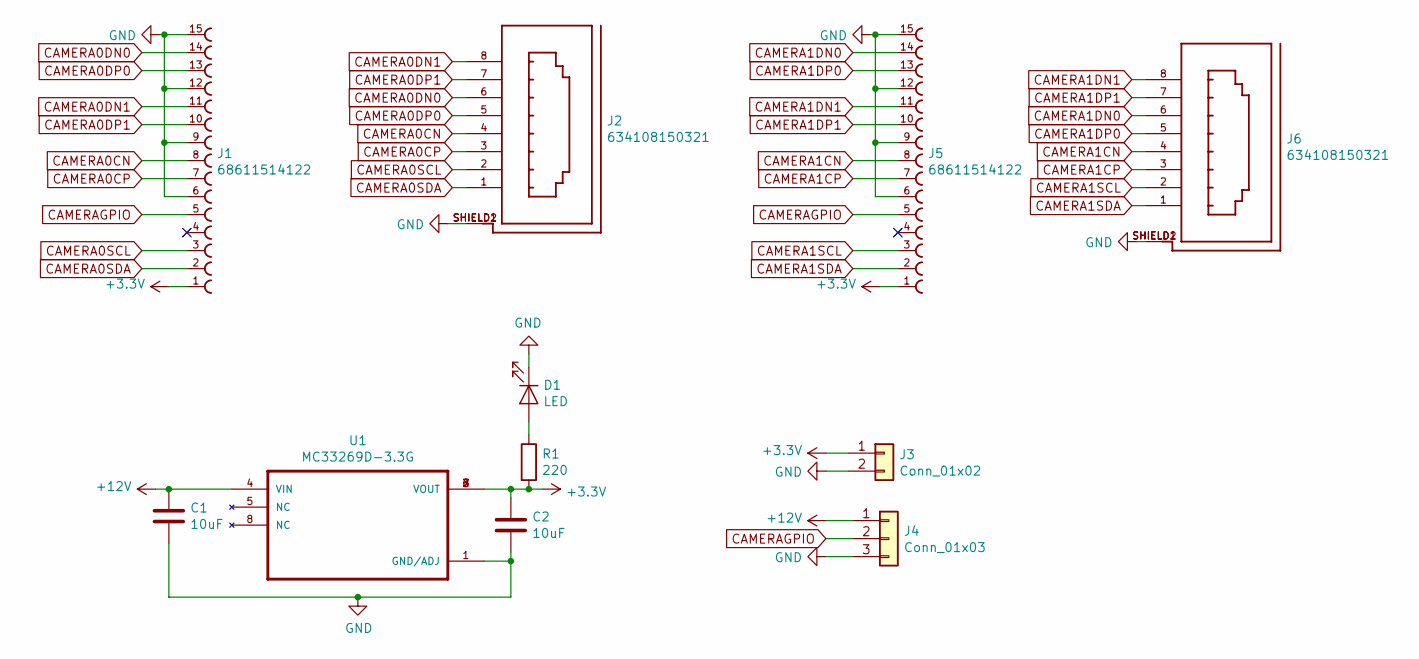
[picture p53: schematic Camera Adapter.sch]

Parts:
C1, C2: 10uF; C_0805_2012Metric_Pad1.15x1.40mm_HandSolder
D1: LED; LED_0805_2012Metric_Pad1.15x1.40mm_HandSolder
J1, J5: 68611514122
J2, J6: 634108150321; WURTH_634108150321
J3: Conn_01x02; PinHeader_1x02_P2.54mm_Vertical
J4: Conn_01x03; JST_PH_S3B-PH-SM4-TB_1x03-1MP_P2.00mm_Horizontal
R1: 220; R_0805_2012Metric_Pad1.15x1.40mm_HandSolder
U1: MC33269D-3.3G; SOIC127P600X175-8N

Connections:
+3V3: C2.1, J1.1 (15), J3.1, J5.1 (15), R1.2, U1.2 (VOUT), U1.3 (VOUT), U1.6 (VOUT), U1.7 (VOUT)
+12V: C1.1, J4.1, U1.4 (VIN)
CAMERA0CN: J1.8, J2.4
CAMERA0CP: J1.7 (9), J2.3
CAMERA0DN0: J1.14 (2), J2.6
CAMERA0DN1: J1.11 (5), J2.8
CAMERA0DP0: J1.13 (3), J2.5
CAMERA0DP1: J1.10 (6), J2.7
CAMERA0SCL: J1.3 (13), J2.2
CAMERA0SDA: J1.2 (14), J2.1
CAMERA1CN: J5.8, J6.4
CAMERA1CP: J5.7 (9), J6.3
CAMERA1DN0: J5.14 (2), J6.6
CAMERA1DN1: J5.11 (5), J6.8
CAMERA1DP0: J5.13 (3), J6.5
CAMERA1DP1: J5.10 (6), J6.7
CAMERA1SCL: J5.3 (13), J6.2
CAMERA1SDA: J5.2 (14), J6.1
CAMERAGPIO: J1.5 (11), J4.2, J5.5 (11)
GND: C1.2, C2.2, D1.1 (K), J1.6 (10), J1.9 (7), J1.12 (4), J1.15 (1), J2.SHIELD1 (SHIELD), J2.SHIELD2 (SHIELD), J3.2, J4.3, J5.6 (10), J5.9 (7), J5.12 (4), J5.15 (1), J6.SHIELD1 (SHIELD), J6.SHIELD2 (SHIELD), U1.1 (GND/ADJ)
unnamed: D1.2 (A), R1.1

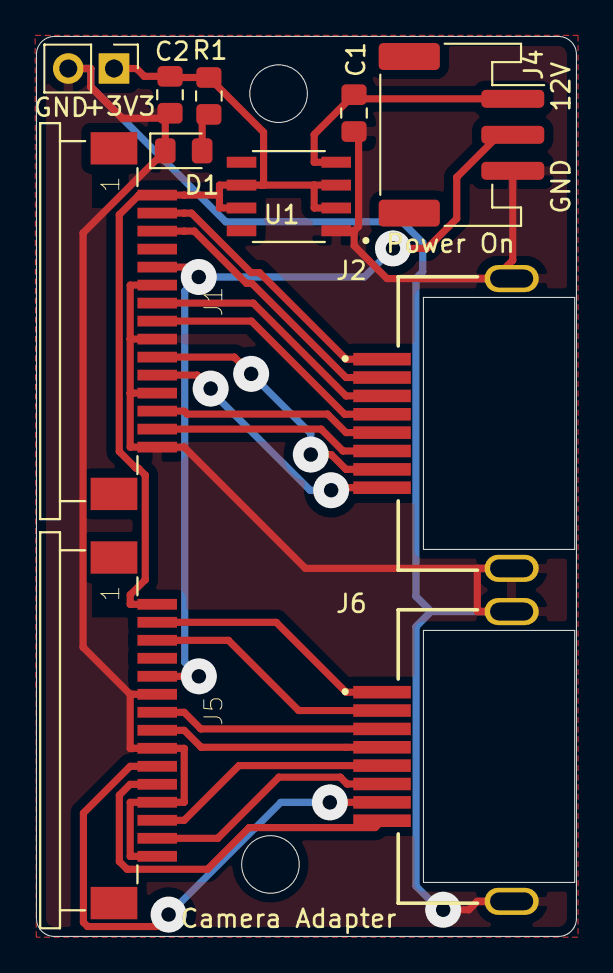
[picture p54: board Camera Adapter.kicad_pcb from above]

Board: 2 copper layers, 30.0 x 50.0 mm, 13 parts (0 on the bottom side), 21 nets.

Other parts of the board:
REF1, REF2: MountingHole_3.2mm_M3_ISO7380
