Yowie-Tool/Scanner-Dev/Line Generator/Legacy/Line Generator.kicad_pcb

## KiCad design Line Generator/Legacy/Line Generator.kicad_pcb (2020-03-11, an earlier design)

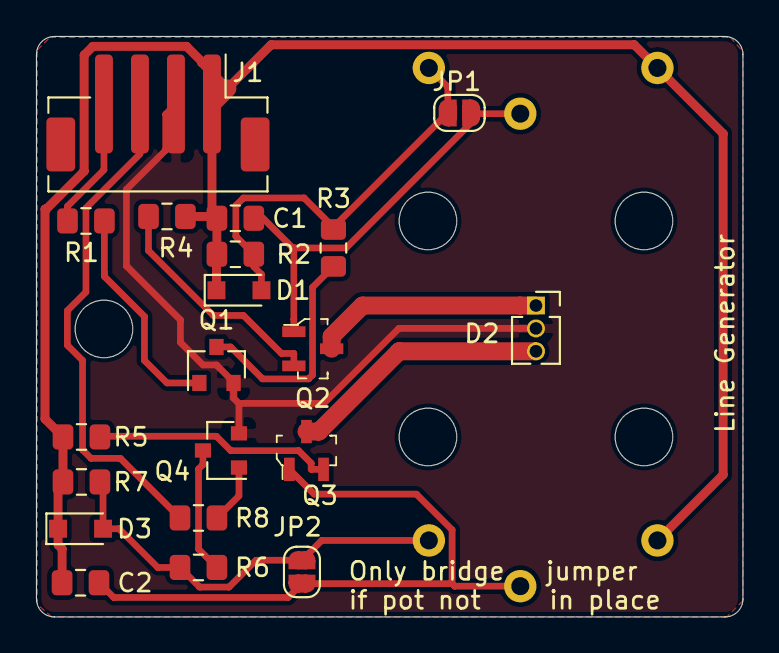
[picture p55: board Line Generator.kicad_pcb from above]

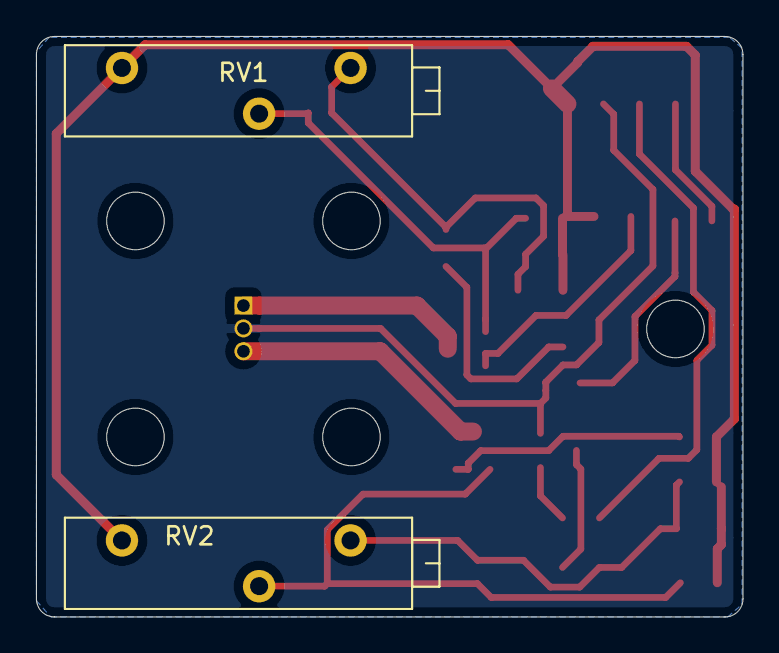
[picture p56: board Line Generator.kicad_pcb from below]

Board: 2 copper layers, 39.2 x 32.2 mm, 27 parts (2 on the bottom side), 16 nets.

Parts:
C1, C2: 0.1uF; C_0805_2012Metric_Pad1.15x1.40mm_HandSolder
D1, D3: D_Schottky 7V; D_SOD-323_HandSoldering
D2: LED_Dual_ACA; PinSocket_1x03_P1.27mm_Vertical
J1: Conn_01x04; JST_PH_B4B-PH-SM4-TB_1x04-1MP_P2.00mm_Vertical
JP1, JP2: SolderJumper_2_Open; SolderJumper-2_P1.3mm_Open_RoundedPad1.0x1.5mm
Mount1, Mount2, Mount3, Mount4, Mount5: MountingHole_3.2mm_M3_ISO7380
Q1, Q4: BS170F; SOT-23
Q2, Q3: BCV46; SOT-23-3
R1, R8: 10K; R_0805_2012Metric_Pad1.15x1.40mm_HandSolder
R2, R7: 100K; R_0805_2012Metric_Pad1.15x1.40mm_HandSolder
R3, R6: 4K7; R_0805_2012Metric_Pad1.15x1.40mm_HandSolder
R4: 68R; R_0805_2012Metric_Pad1.15x1.40mm_HandSolder
R5: 33R; R_0805_2012Metric_Pad1.15x1.40mm_HandSolder
RV1, RV2: 22K; Potentiometer_Bourns_3006P_Horizontal

Connections:
+12V: C1.2, C2.2, D1.1, D3.1, J1.1, R2.1, R4.2, R5.2, R7.1, RV1.1, RV2.1
GND: D2.2, J1.2, Q1.2, Q4.2
Laser1: J1.3, R8.2
Laser2: J1.4, R1.2
unnamed: C1.1, JP1.2, Q2.1, RV1.2
unnamed: C2.1, JP2.2, Q3.1, RV2.2
unnamed: D1.2, JP1.1, R2.2, R3.1, RV1.3
unnamed: D2.1, Q2.3
unnamed: D2.3, Q3.3
unnamed: D3.2, JP2.1, R6.1, R7.2, RV2.3
unnamed: Q1.1, R1.1
unnamed: Q1.3, R3.2
unnamed: Q2.2, R4.1
unnamed: Q3.2, R5.1
unnamed: Q4.1, R8.1
unnamed: Q4.3, R6.2
