Yowie-Tool/Scanner-Dev/TempTopBoard/GERBER/GCode/back.g

; pcb2gcode 2.0.0 
; Software-independent Gcode 

G94 ; Millimeters per minute feed rate. 
G21 ; Units == Millimeters. 

G90 ; Absolute coordinates. 
;G1 F3000 S10000 ; RPM spindle speed. 
G1 F300 F600.00000 ; Feedrate. 


G1 F3000 Z3.00000 ;Retract to tool change height
;T0
;M5      ;Spindle stop.
;G04 P1.00000 ;Wait for spindle to stop
;MSG, Change tool bit to mill diameter 0.12000mm
;M6      ;Tool change.
;M0      ;Temporary machine stop.
;M3 ; Spindle on clockwise. 
;G04 P1.00000 ;Wait for spindle to get up to speed
;G04 P0 ; dwell for no time -- G64 should not smooth over this point 
G1 F3000 Z3.00000 ; retract 

G1 F3000 X-1.65956 Y25.17601 ; rapid move to begin. 
G1 F300 F300.00000
G1 F300 Z-0.07000
;G04 P0 ; dwell for no time -- G64 should not smooth over this point 
G1 F300 F600.00000
G1 F300 X-1.65956 Y25.17601
G1 F300 X-1.66947 Y25.07261
G1 F300 X-1.70020 Y24.96727
G1 F300 X-1.75093 Y24.86997
G1 F300 X-1.81963 Y24.78442
G1 F300 X-3.10297 Y23.50108
G1 F300 X-3.18852 Y23.43238
G1 F300 X-3.28582 Y23.38165
G1 F300 X-3.39116 Y23.35092
G1 F300 X-3.61745 Y23.34101
G1 F300 X-3.73149 Y23.26263
G1 F300 X-3.90957 Y23.24101
G1 F300 X-3.90957 Y15.60105
G1 F300 X-3.92176 Y15.48606
G1 F300 X-4.00094 Y15.29498
G1 F300 X-4.07361 Y15.20506
G1 F300 X-9.52798 Y9.75110
G1 F300 X-9.69996 Y9.63619
G1 F300 X-9.81616 Y9.60093
G1 F300 X-10.85960 Y9.59103
G1 F300 X-10.86074 Y9.33931
G1 F300 X-10.87717 Y9.30858
G1 F300 X-10.90788 Y9.29217
G1 F300 X-12.53130 Y9.29217
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
G1 F300 X-63.11476 Y59.00259
G1 F300 X-62.99259 Y59.03965
G1 F300 X-62.86513 Y59.05219
G1 F300 X-31.67944 Y59.04902
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

;G04 P0 ; dwell for no time -- G64 should not smooth over this point 
G1 F3000 Z3.000 ; retract 

;M5 ; Spindle off. 
;G04 P1.000000
;M9 ; Coolant off. 
M0 ; Program end. 
