Yowie-Tool/Scanner-Dev/(commit log)

2020-03-01 Create Line Generator PCB
2020-03-02 Removed line generator from Simulator folder; left it in root.
    [Line Generator.dsn, Line Generator.kicad_pcb, Line Generator.sch, Line Generator.step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]
2020-03-02 Tidying line generator circuit diagram.
2020-03-06 PCB Layout altered for Adrian's Circuit design
    [Line Generator.kicad_pcb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]
2020-03-07 Changed footprints on Resistors
    [Line Generator-B_SilkS.gbr, Line Generator-Edge_Cuts.gbr, Line Generator-F_Cu.gbr, Line Generator-F_SilkS.gbr, Line Generator.drl]
2020-03-10 Add 2D top board
    [2D Top Board.dsn, 2D Top Board.kicad_pcb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]
2020-03-11 Track widths increased
    [Line Generator-B_Cu.gbr, Line Generator-B_Mask.gbr, Line Generator-B_SilkS.gbr, Line Generator-Edge_Cuts.gbr, Line Generator-F_Cu.gbr, Line Generator-F_Mask.gbr, Line Generator-F_Paste.gbr, Line Generator-F_SilkS.gbr]
2020-03-11 Updated top board
    [2D Top Board-B_Cu.gbl, 2D Top Board-B_Mask.gbs, 2D Top Board-B_SilkS.gbo, 2D Top Board-Edge_Cuts.gm1, 2D Top Board-F_Cu.gtl, 2D Top Board-F_Mask.gts, 2D Top Board-F_Paste.gtp, 2D Top Board-F_SilkS.gto]
2020-04-03 Add in camera adapter board
    [Camera Adapter-B_Cu.gbr, Camera Adapter-B_Mask.gbr, Camera Adapter-B_Paste.gbr, Camera Adapter-B_SilkS.gbr, Camera Adapter-Edge_Cuts.gbr, Camera Adapter-F_Cu.gbr, Camera Adapter-F_Mask.gbr, Camera Adapter-F_Paste.gbr]
2020-04-04 Change to different ZIF connector
    [Camera Adapter-B_Cu.gbr, Camera Adapter-B_Mask.gbr, Camera Adapter-B_Paste.gbr, Camera Adapter-B_SilkS.gbr, Camera Adapter-Edge_Cuts.gbr, Camera Adapter-F_Cu.gbr, Camera Adapter-F_Mask.gbr, Camera Adapter-F_Paste.gbr]
2020-04-05 Updated for bigger vias (2mm)
    2.5mm wouldn't quite fit...
    [Camera Adapter-B_Cu.gbr, Camera Adapter-B_Mask.gbr, Camera Adapter-B_Paste.gbr, Camera Adapter-B_SilkS.gbr, Camera Adapter-Edge_Cuts.gbr, Camera Adapter-F_Cu.gbr, Camera Adapter-F_Mask.gbr, Camera Adapter-F_Paste.gbr]
2020-04-05 Updated KiCad files
    [Camera Adapter.kicad_pcb, Camera Adapter.sch]
2020-06-17 Cameras WIP. Ray-trace from pixel - lines' closest points function implemented.
2020-06-18 Speeding up ray tracing by precomputing a mask of pixels to be traced. WIP.
2020-06-26 Updating PCBs
    [2D Top Board-B_Cu.gbl, 2D Top Board-B_Mask.gbs, 2D Top Board-B_SilkS.gbo, 2D Top Board-Edge_Cuts.gm1, 2D Top Board-F_Cu.gtl, 2D Top Board-F_Mask.gts, 2D Top Board-F_Paste.gtp, 2D Top Board-F_SilkS.gto]
2020-07-11 Work In progress 2D Scanner STEP file
    White parts - 3D Printed (these should be relatively obvious!)
    Silver parts - Aluminium
    Black parts - Hard anodized Aluminium
    Blue Parts - Laser cut acrylic
    This is a WIP assembly, I haven't added anything (yet) to stop the laser and cameras rotating about their respective axis yet, nor anything to adjust the friction on the rotary axis (the spring and washers are there, just nothing pressing on the top washer). And obviously the back panels and top panel is missing (2 back panels split around the screen). Also, no reed switch, nor on and off switch, etc, etc...
2020-07-16 Work in progress 2D Scanner STEP
    More progress. Not yet added an on off switch or reed switch
2020-07-17 Now includes the HQ cam.
    Current settings are:
    Camera type 1
    Camera 1 offset 345mm
    Camera 2 offset 450mm
    Cam 1 max resolution 2mm
    cam 2 max resolution 4mm
    Minimum measurement 500mm
    overlap - 100mm ish. (can't quite remember!)
    This will give you focal lengths of approx 8 and 25mm.
2020-07-27 Adding camera calculation spreadsheets.
    [Camera Lenses.xlsx, camera-variables.ods]
2020-07-28 Added calculation for L to the camera spreadsheet.
    [camera-variables.ods]
2020-08-27 Create TopBoardTester.ino
    Top board testing program for Arduino - doesn't work!
    [TopBoardTester.ino]
2020-09-01 Update TopBoardTester.ino
    Updated top board tester
2020-09-01 Update TopBoardTester.ino
    Mistakes corrected. Now works perfectly!
    [TopBoardTester.ino]
2020-09-08 Library files added
    [1-1734248-5.stl, 1-1734248-5.stp, 647676-2.igs, 647676-2.stl, 647676-2.x_b, 68611514122_Download_STP_68611514122_rev1.stp, 87832-1211.stl, 87832-1211.stp]
2020-09-08 updated library paths
    [Top Board.sch]
2020-09-08 i2c only version added
2020-09-11 Corrected MC14555BDG to include a GND connection
    [Top Board.kicad_pcb, Top Board.sch]
2020-09-21 Added new temprary top board; small redesign by AB to make easier to cut.
    [Temp Top Board.kicad_pcb, Temp Top Board.sch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]
2020-09-21 GCodes for cutting new PCB done.
    [Temp Top Board.kicad_pcb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]
2020-09-29 STL Files for Lens bodies added
    [SS2DP078 7.5mm Focal length lens holder - SLA .stl, SS2DP079 25mm Focal length lens holder - SLA v2.stl]
2020-10-03 STL files for printing
    [SS2DP029 Line Generator Mount.stl, SS2DP078 7.5mm Focal length lens holder - SLA v4.stl, SS2DP079 25mm Focal length lens holder - SLA v4.stl]
2020-10-03 Update SS2DP029 Line Generator Mount.stl
    [SS2DP029 Line Generator Mount.stl]
2020-10-04 New mounts for vertical screen and rotated pi
    [SS2DP045 Screen Support 1.stl, SS2DP080 Standalone Screen Mount.stl]
2020-10-09 Find point in space from camera pixel added to simulator.
    [SS2DP029 Line Generator Mount.stp, SS2DP045 Screen Support 1.stl, SS2DP080 Standalone Screen Mount.stl, back.g, drill.g, james-3-10-20.3mf, james-4-10-20.3mf, lens-holders.3mf]
2020-10-10 New Lens mounts, new Pi mount (adjustable)
    [SS2DP045 Screen Support 1.stl, SS2DP076 7.5mm Focal length lens holder v2.stl, SS2DP077 25mm Focal length lens holder v4.stl, SS2DP078 7.5mm Focal length lens holder - SLA v4.stl, SS2DP079 25mm Focal length lens holder - SLA v4.stl]
2020-10-10 Added base parts
    [SS2DP003 Base Support V2.stl, SS2DP039 Base Cable Protector.stl]
2020-10-10 Create SS2DP081 Additional Back Panel Mount.stl
    Added panel mount
    [SS2DP081 Additional Back Panel Mount.stl]
2020-11-02 Separating simulator model from FreeCAD dependency. W.I.P.
    [james-11-10-20.3mf]
2021-01-14 Improved (?) constant current circuits for the line generator V2.
    [Line Generator-B_Cu.gbr, Line Generator-B_Mask.gbr, Line Generator-B_SilkS.gbr, Line Generator-Edge_Cuts.gbr, Line Generator-F_Cu.gbr, Line Generator-F_Mask.gbr, Line Generator-F_Paste.gbr, Line Generator-F_SilkS.gbr]
2021-01-14 Now with 5V power...
    [Line-Generator-V2.sch]
2021-01-14 Now with adjustable LED current.
    [Line-Generator-V2.sch]
2021-01-22 Latest laser circuit. Maybe final?!?
    [Line-Generator-V2.sch]
2021-01-26 PCB layout
    [Line-Generator-V2.dsn, Line-Generator-V2.kicad_pcb]
2021-01-27 Updated PCB layout
    Added vias to improve soldering
    [Line-Generator-V2.kicad_pcb, Line-Generator-V2.sch]
2021-01-27 Minor changes
    [Line-Generator-V2.kicad_pcb, Line-Generator-V2.sch]
2021-01-28 Updated PCB layout as per AB suggestion
    [Line-Generator-V2.kicad_pcb]
2021-02-08 WIP on the calibration simulation.
2021-02-12 New Camera Adapter
    For USB C, with 3.3v voltage protection circuit
    [Small Camera Adapter-B_Cu.gbr, Small Camera Adapter-B_Mask.gbr, Small Camera Adapter-B_Paste.gbr, Small Camera Adapter-B_SilkS.gbr, Small Camera Adapter-Edge_Cuts.gbr, Small Camera Adapter-F_Cu.gbr, Small Camera Adapter-F_Mask.gbr, Small Camera Adapter-F_Paste.gbr]
2021-03-02 Beginning to develop the calibration software. WIP...
2021-03-03 WIP on scanner calibration.
2021-03-05 Calibration proposal document added.
2021-03-05 Final Line Generator for prototype production
    [Line-Generator-V2-B_Cu.gbr, Line-Generator-V2-B_Mask.gbr, Line-Generator-V2-B_Paste.gbr, Line-Generator-V2-B_SilkS.gbr, Line-Generator-V2-Edge_Cuts.gbr, Line-Generator-V2-F_Cu.gbr, Line-Generator-V2-F_Mask.gbr, Line-Generator-V2-F_Paste.gbr]
2021-03-05 Update to camera adapter
    [10137062c.stp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]
2021-03-16 Set up the calibration simulation as a PyCharm IDE project.
2021-03-16 Calibration program WIP.
2021-03-17 Code tidying.
    Calibration WIP.
    There's an error somewhere (or maybe it's the ill-conditioned
    nature of the problem, in which case, Arrrgh!) because feeding triangle corners into a scanner
    with zero errors gives a sum of squared errors that is not zero.
    More WIP needed. Also needed: gradient descent function minimisation; there may well be
    a Python library somewhere for this. To be done.
2021-03-22 Calibration WIP.
2021-04-06 Fixed bug in scanner simulation function that intersects rays and planes. Now reconstructs points in space accurately. Calibration using random configurations of scanner works, but is not accurate en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
2021-04-07 Scanner calibration now uses scipy's minimize() multidimensional optimisation to get a scanner that reconstructs the test triangles as close as possible. It does this well (RMS error of all triangle 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
    Conjecture - we need to do the calibration at more than one Z value to pin
    things down. To be investigated...
2021-04-08 Final (?) version of the calibration program.
    Results of the calibration experiments indicate that calibrating just using
    triangle side lengths gives a poor result, whereas calibrating against known
    points in space gives superb results.
    Maybe a big frame with white-painted vertical wires in known positions
    against a black background?
2021-04-28 Simulation of using a piece of A4 paper to check for scanner errors in the field added.
    [scanner-error-and-A4-paper-edge-error.ods]
2021-04-28 Trying the A4 paper idea with smaller errors.
    [scanner-error-and-A4-paper-edge-error.ods]
2021-09-27 WIP calibration...
2021-10-05 More messing about with calibration...
2021-10-29 Bug in triangle calibration simulation fixed.
2021-11-04 Calibration WIP...
2021-11-09 Triangle calibration WIP...
2021-11-09 Interactive calibration: some progress... Not yet finished.
2021-11-15 More work on the calibration from scanned triangles...
2021-11-18 Calibration WIP. Triangle fitting by optimisation still not working...
